jthyn1/underwater_multi-medium_modem_system/README.md

# underwater_multi-medium_modem_system
As part of development of the KnifeBot III underwater ROV in the CA-AI lab, software designated to the seamless operation and access of several underwater modems under the same system, with use-case examples included.
