jthyn1/underwater_multi-medium_modem_system/Documentation/Identify Standards in our project.docx

1) TCP/IP (Internet Protocol Suite – IETF Standard) (Mario Rodriguez)

1. The standard body: Internet Engineering Task Force (IETF)

2. what is the official standard number/identification; if there are multiple related standards, describe the purpose of the multiple standards and list the number for one of the standards

Number: RFC-793, RFC-791
Purpose: Transmission Control/IP is intended for reliable host–to–host connections for multi-network environments. The TCP/IP protocol relies on the internet to handle reassembly and fragmented packets when transmission. The Internet protocol is layered below the TCP protocol.

3) what is the official name of the standard

- Transmission control protocol

2) HTTP (Hypertext Transfer Protocol (Laiba)

1. The standard body: Internet Engineering Task Force (IETF)

2. Official standard number/identification: HTTP uses many related standards called Requests for Comments (RFC) that are published by the Internet Engineering Task Force. These different RFG documents exist because each focuses on a different part of how HTTP works. For example, the structure of messages, or the communication between the client and the server. One of the most current standard is RFC 9110

3. Official name of the standard: RFC 9110 – HTTP Semantics

Source: https://datatracker.ietf.org/doc/html/rfc9110

3). Python programming language (Laiba)

1. The standards body: Python Software Foundation (PSF)

2. official standard number/Identification: Python does not have a official ISO or IEEE standard number like how our other technologies have. Instead, Python uses a Python Enhancement Proposal (PEP) system, which is used for changing documents and making improvements to the language. Each PEP focuses on a different aspects of Python. For example, PEP 8 is the most common standard that gives you a guide on how to write clean and easy code.

3. official name of the standard: PEP 8- Style Guide for Python Code

Source: https://docs.python.org/3/reference/

4.) IEEE 802 Networking Model (Nicholas Alberto)

1. The standard body: Institute of Electrical and Electronics Engineers (IEEE)

2. what is the official standard number/identification; if there are multiple related standards, describe the purpose of the multiple standards and list the number for one of the standards:

This standard defines networking technologies used in local area networks. Its how devices communicate at the physical and data link layers, including how data frames are transmitted between devices on a wired or wireless network. It also includes standards such as ethernet and Wi-Fi.

3. what is the official name of the standard:

IEEE 802 local area network and metropolitan area network standards

5) RS-232 Serial Communication Standard (EIA/TIA-232) (Nicholas Alberto)

1. The standard body:

Electronic industries Alliance and telecommunications industry association

2. what is the official standard number/identification; if there are multiple related standards, describe the purpose of the multiple standards and list the number for one of the standards:

This standard defines serial communication between devices such as computers and hardware peripherals. It described voltage levels, signal timing, and data transmission methods used in serial ports.

3. what is the official name of the standard:

Interface between data terminal equipment and data circuit terminating equipment

6) POSIX (Portable Operating System Interface) (Mario Rodriguez)

1. The standard body: IEEE Computer Society

2) What is the official standard number/identification; if there are multiple related standards, describe the purpose of the multiple standards and list the number for one of the standards.

Number: IEEE Std 1003.1 - 2024
Purpose: Portable Operating System Interface (POSIX) is for portable microcontrollers, either with or without graphical user interfaces (GUI). The interface is specifically designed for several groups of consumers, the commercial users which use the best within their respective computational tasks. The average consumer of hardware and software systems, people who implement their own software/hardware on top of this architecture for the operating system of the portable devices, and lastly those who need it for portable applications. POSIX will utilize several features present in general purpose computers. These include similar naming schemas, similar interface systems ideally with their own customized but same shells/utilities and then rationale. POSIX because its development has been essential to our development of our hardware/software applications.

3) What is the official name of the standard.

- IEEE Standard for Information Technology - Portable Operating System Interface (POSIX)

IP Addressing Standard (IPv4/IPv6 - IETF)

Allows devices on your network (e.g., 192.168.x.x or 10.0.x.x) to uniquely identify and communicate with each other.

7) Raspberry Pi Linux Scheduling (crontab) David Osemene

- Standards Body: The Open Group
- Standard Number: POSIX IEEE 1003.1
- Official Name: Portable Operating System Interface (POSIX) Base Specifications

Explanation:

The cron/crontab command follows the POSIX standard, enabling the scheduling of scripts to run at specified times. This command is used for the Linux operating system. In this project, it is utilized for the automation of scripts at the time of booting the Raspberry Pi.

8) 3D Mechanical Design (SolidWorks CAD) David Osemene

- Standards Body: International Organization for Standardization (ISO)
- Standard Number: ISO 10303 (STEP)
- Official Name: Industrial Automation Systems and Integration — Product Data Representation and Exchange

Explanation:

3D mechanical components such as the enclosure frame that holds all our boards are designed in SolidWorks. The STEP standard allows CAD models to be exchanged between different design and manufacturing software.

Jeremy Thyn:

9) Ethernet

Standard body: IEEE

Standard Number: IEEE 802.3

Official Name: Standard for Ethernet

IEEE Standard 802.3 depicts the technology behind ethernet cables and connections and how they are used. Specifies the MAC (media access control), MIB (managment information base), and many other aspects of the communication protocol. We are currently using it to connect the underwater optical modem to our raspberry pi.

10) LoRa

Standard body: IEEE

Standard Number: IEEE SA - P1451.5.5

Official Name: Standard for a Smart Transducer Interface for Sensors and Actuator -- Wireless Communication Protocols and Transducer Electronic Data Sheet (TEDS) Formats - LoRa Protocol

LoRa (or low power long range) is another form of data communication being used in our project. A LoRa module will be connected to our unit and allow for interfacing with the unit remotely to talk to the raspberry pi without having to have a direct wired interface with it. LoRa specifically is being used as the long range low power nature of it allows for a long distance minimal attenuation, although bps limited communication to receive incoming sensor data and transmission of basic instructions to the unit.

References:

[1] IEEE SA - standard for a smart transducer interface for sensors and actuator -- wireless communication protocols and Transducer Electronic Data Sheet (TEDS) formats - Lora Protocol. IEEE Standards Association. (n.d.). https://standards.ieee.org/ieee/1451.5.5/10611/

[2] IEEE SA - IEEE Standard for ethernet. IEEE Standards Association. (n.d.-a). https://standards.ieee.org/ieee/802.3/10422/

[3]

[4]

[5]

[6]

[7] "IEEE/Open Group Standard for Information Technology--Portable Operating System Interface (POSIX™) Base Specifications, Issue 8," in IEEE/Open Group Std 1003.1-2024 (Revision of IEEE Std 1003.1-2017) , vol., no., pp.1-4107, 14 June 2024, doi: 10.1109/IEEESTD.2024.10555529. keywords: {IEEE Standards;Information technology;Open systems;Operating systems;Application programming interfaces;application program interface (API);argument;asynchronous;basic regular expression (BRE);built-in utility;byte;child;command language interpreter;CPU;extended regular expression (ERE);FIFO;file access control mechanism;IEEE 1003.1™;input/output (I/O);job control;network;parent;portable operating system interface (POSIX™);shell;stream;string;synchronous;system;thread;X/Open System Interface (XSI)},

[8] The Open Group. (2018). The Open Group Base Specifications Issue 7, IEEE Std 1003.1-2017 (POSIX). Retrieved from https://pubs.opengroup.org/onlinepubs/9699919799/

Linux manual page for crontab:
https://man7.org/linux/man-pages/man5/crontab.5.html

[9] International Organization for Standardization. (2021). ISO 10303: Industrial automation systems and integration — Product data representation and exchange. Retrieved from https://www.iso.org/standard/63141.html
