jthyn1/underwater_multi-medium_modem_system/Documentation/Module 8 - Requirements Specifications and System Level Design.docx

Requirements

Specifications for KnifeBot Modem

Laiba Baig

Jermey Thyn

David Osemene

Nicholas Alberto

Mario Rodriguez Avila

Sponsor

Dr. Georgios Sklivanitis

College of Engineering and Computer Science

________________________

The College of Computer Science and Electrical Engineering

777 Glades Road, Boca Raton, FL 33431

Version: 1.0

# Table of Contents

# 1. Introduction

In this document, we will discuss a high-abstraction level of detail for the operation of the Underwater Multimodal Modem for the Knifebot fish robot. We will base this document on the IEEE-830 standard Recommended Practice for Software Requirements Specifications[^1]. Though the project we are creating is not exclusive to software, it still provides a good foundation on which to build our requirements specification. These standards address functionality, interfacing, performance, attributes, and design constraints. It is important to note that this document will not go over design requirements.

### 1.1 Definitions

- Modem – a device that sends and receives data between two signals
- Buoy – A device that helps relay signals between underwater systems and the surface
- Knifebot – An underwater robot that collects data and performs tasks
- Surface Station – The main controls unit that will be user controlled above the surface of the water
- Hydrophone – an underwater microphone that analyzes sound in water by converting it into electrical signals.

# 2. Functionality

The purpose of this project is to create a reliable way for the KnifeBot to communicate underwater by using both acoustic and optical sensors. This helps the robot send data and receive commands from the surface even when the water conditions change and are not ideal. The goal is to improve underwater research and exploration by building a system that can switch between communications to keep the connection strong.

The Underwater Multimodal Modem:

- Enables two-way underwater communication between the KnifeBot and the surface station
- Transmits control commands from the operator to the KnifeBot and send sensor data from the KnifeBot to the surface station in real time
- Allows for multiple underwater modems to communicate within a swarm network without interference
- Monitors the acoustic and optical signals’ strength
- Gives feedback if communication failures happen.

# 3. Interfacing

The modem exists as a transceiver and allows for receiving and sending signals acoustically and/or optically with infrared light. The transceiver will interact with other Knifebots directly or with the surface station. Once a signal is received by the modem, it will be forwarded to the main CPU of the Knifebot, which will determine what the Knifebot will do with the information. The way the modem interfaces is the core of its use, as it is designed as an apparatus for communication of the Knifebot to the rest of the world around it.

# 4. Performance

When reviewing the performance of the modem, we can look individually at the performance of both the optical and acoustic communication subsystems:

## 4.1 Optical Performance

The performance of the modem is dependent on the bandwidth of the signals used with the acoustic and optical portions of the modem. The infrared light portion of the modem uses IR light diodes that, based on the power and arrangement, can transmit up to 4 Mbps. The IrDA (Infrared Data Association) has standard operational parameters for IR communications, which include SIR (Slow IR) at 115 Kbps, MIR (Medium IR) at 1 Mbps, and FIR (Fast IR) at 4 Mbps[^2]. The main drawback of all IR communications is range, as it can only operate at around 3.3 ft, which is further limited by environmental conditions (specifically within the ocean, the clarity of the water is a major issue for any optical communication).

## 4.2 Acoustic Performance

The acoustic part of the modem will be able to operate at a much longer distance regardless of water conditions, however the amount of data able to be transferred will be significantly smaller. There are many different techniques to use acoustics for communication, one of which is FSK (Frequency Shift Keying), which involves having logic 1 and logic 0 assigned to different frequencies that are transmitted/received[^3]. Telemetry using this method can reach up to 5 kbps using multiple FSK channels between 20 kHz and 30 kHz, and at this range we can expect an operating distance anywhere between 10-100 km[^4]. The acoustic modems will use hydrophones to further assist in filtering sound waves. This instrument will be crucial for practical applications and allow better end-to-end communication as a result.

## 4.3 Buoy System

This is a buoy system that functions as a capable monitoring station in the oceans meant to help in data transmission over a long period. It is also fitted with a data logger that consumes a less amount of power as well as a communication device that enables data transmission in real time. It is battery-operated, capable of operating indefinitely in the water as well as in harsh weather. Its transmission range is usually a distance of up to 10km via cellphone/radio communication.

# 5. Attributes

In the IEEE-830 standards, the attributes of a given requirements specifications include reliability, availability, security, maintainability, and portability. For the scope of this document, however, we can omit the availability metric as the only availability necessary is through the CPU.

## 5.1 Reliability

When discussing reliability in the context of the IEEE-830 standards, we are talking about what is required to ensure reliable function of the modem. This includes enough power being driven to the modem to support equal usage of both the optical and acoustic parts, thorough testing of the code that drives the modem to ensure minimal errors and testing in multiple environments to determine potential environmental reliability factors that can be addressed. A performance test will be conducted with parameters that determine if the modem is operational to the desired standard.

## 5.2 Security

While security on the software end is minimal as it is unlikely that the modem will be the subject of a hack, the hardware must be protective enough to stop any external tinkering and any water damage. This means a watertight seal within the Knifebot is essential, so the size of the modem must be considered. Additionally, the materials used to embed the modem should be safe for long use in salt water without rusting, and all connections should lock securely, so they do not come loose during use.

## 5.3 Maintainability

The software that the modem contains is easy to maintain and is done so by design. The Knifebot is based on user use-cases, and therefore the code of what it will do will change often. If the software is not easily updated, then its user-end use will suffer greatly. Additionally, the Knifebot is still well into its development cycle, meaning that the software of the modem is changed often to fit the needs of testing, and maintainability is critical.

## 5.4 Portability

The main case of needing portability within the modem is very similar to the reasons for maintainability: user-use cases. Being able to easily implement the same system that is used for communication between the Knifebots, buoys, and the surface station can be implemented within other systems such as foreign buoys or a manual remote controller, based on the user’s preference.

# 6. Design Constraints

At a high level, these are some of the constraints that are part of development:

- The system provides a simple interface for users to monitor connection status and mode (acoustic/optical)
- The system supports integration with the Knifebot control software
- There are adjustable signal settings like range and frequency
- The system shows a warning if the signal is weak or the connection to the surface station or other Knifebots are lost

# 7. Safety Requirements

- The system should be fully waterproof to prevent any water damage
- The materials used should be safe for long use in salt water without rusting
- Making sure the modem does not overheat when used for a long period of time
- It should use a safe amount of voltage to avoid any electrical shock
- All connections should lock securely so they do not come loose during usage

# 8. State Descriptions and Transitions

The underwater Multimodal Modem for Knifebot system includes both surface and underwater components that work together to keep communication stable. The surface control station sends commands to the surface buoy, which relays those signals underwater to the modem. The modem goes through different states depending on the environment and signal condition, then sends the data collected back up to the surface buoy.

## 8.1: States

- Surface control station: The user controls the system, starts the task, and receives data once everything is completed
- Surface buoy network: the buoy sends commands from the surface station down to the modem and sends data back up from underwater
- Idle State: The modem is turned on and waiting for the start command
- Environmental check state: The modem checks the water conditions, distance, and signals to choose the best communication mode
- Optical mode: It is used when the water is clear, the buoy is close, and the signal is strong for fast data
- Acoustic mode: It is used when the water is cloudy, the buoy is far, or the signal is weak for longer but slower communication
- Error recovery: used when the signal is lost, the system tries to fix the connection or

switch to a better mode

## 8.2: State transitions

- Surface control station to surface buoy: The user sends a start command to begin
- Surface Buoy to Idle state: the buoy sends the commands to turn on and activate the modem
- Idle to Environmental check: The modem starts checking water condition, distance and signals
- Environmental check to optical mode: if the water is clear, the buoy is close, and the signal is strong
- Environmental check to acoustic mode: if the water is cloudy, the buoy is far, and the signal is weak
- Optical/acoustic mode to Error recovery: There is a problem with the connection status
- Error recovery to Environmental check: after fixing the connection, the system checks conditions again
- Environmental check to Idle: when the task is complete and has ended, the model returns to standby mode
- Idle to Surface buoy to surface control station: the modem sends all the data that was collected to the user through the buoy

# 9. System Level Block Diagram

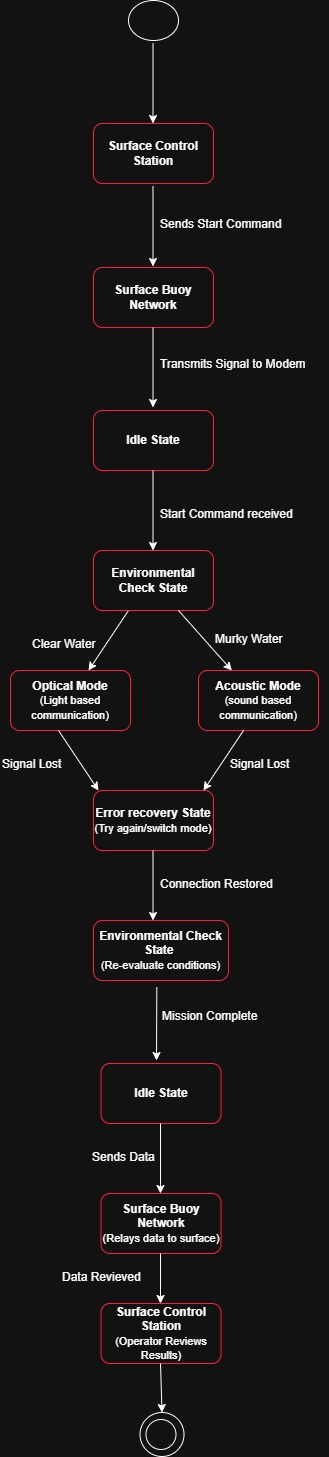
[picture p14: figure]

(Fig 1. System Level Block Diagram for KnifeBot Modem)

## 10.1: Operational Cases

#### 10.1.1: Operation With Clear Water

The user sends a start command from the surface control station through the buoy to the modem. The system moves from idle to environmental check, then switches to optical mode since the water is clear, and the buoy is close. The Knifebot collects the data and sends it back through the buoy. When the task ends, the modem returns idle and sends the data to the surface.

#### 10.1.2: Operation with Murky Water

During the task the modem is working with the optical, but the signal starts to weaken because of cloudy water, or the distance becomes greater than before. The system moves to error recovery state and tries to reconnect. It switches to Acoustic mode through the controller for a more stable connection. After restoring the signal, it returns to environmental check to verify the conditions then continues transmitting data through the buoy until the task is completed.

# 11. References:

"IEEE Recommended Practice for Software Requirements Specifications," in IEEE Std 830-1998 , vol., no., pp.1-40, 20 Oct. 1998, doi: 10.1109/IEEESTD.1998.88286.
keywords: {Software requirements and specifications;contract;customer;prototyping;software requirements specification;supplier;system requirements specifications}

Hydromea SA. “LUMA X and LUMA X-UV Manual.” Feb. 2024, https://files.hydromea.com/luma/LUMA_X_and_LUMA_X-UV_manual.pdf.

Popoto News. “Introducing the PMM4511 – Our New Compact and Efficient OEM Acoustic Modem.” September 30, 2025, Sep. 2025, p. 1, https://www.popotomodem.com/blog/09-30-2025/.

delResearchLLC. “User’sGuidefor PMM5544 M2000/M6000 DB100-55.” Popoto Modem, Jan. 2022, https://www.popotomodem.com/static/17704245ba22b453f7e532e2d40273ee/PMM5544UsersGuide.pdf.

Stojanovic, Milica, and Pierre-Philippe J. Beaujean. Acoustic Communication. https://millitsa.coe.neu.edu/publications/book/handbook-chap5.pdf.

Lish, Tom. “What Is a Data Buoy?” Setra Systems Blog, 25 Jan. 2018,

https://www.setra.com/blog/what-is-a-data-buoy

Campagnaro, F., Steinmetz, F., Renner, B.-C., & Zorzi, M. (2023). Affordable underwater acoustic modems and their application in everyday life: a complete overview. In Proceedings of the 17th International Conference on Underwater Networks & Systems (WUWNet ’23), November 24-26, 2023, Shenzhen, China. ACM. https://doi.org/10.1145/3631726.3631734

[^1] IEEE SA - IEEE Recommended Practice for Software Requirements Specifications. IEEE Standards Association. (n.d.). https://standards.ieee.org/ieee/830/1222/
[^2] Frenzel, L. E. (2005, August 17). IR transceivers boost speed and range. Electronic Design. https://www.electronicdesign.com/technologies/communications/article/21765365/ir-transceivers-boost-speed-and-range
[^3] Froehlich, A. (2021, October 1). What is frequency-shift keying (FSK)?. Search Networking. https://www.techtarget.com/searchnetworking/definition/frequency-shift-keying
[^4] Stojanovic, M. (n.d.). MIT. http://web.mit.edu/millitsa/www/resources/pdfs/ency.pdf
