jthyn1/underwater_multi-medium_modem_system/Documentation/SPRING 2026 SENIOR SHOWCASE POSTER TEMPLATE.pdf

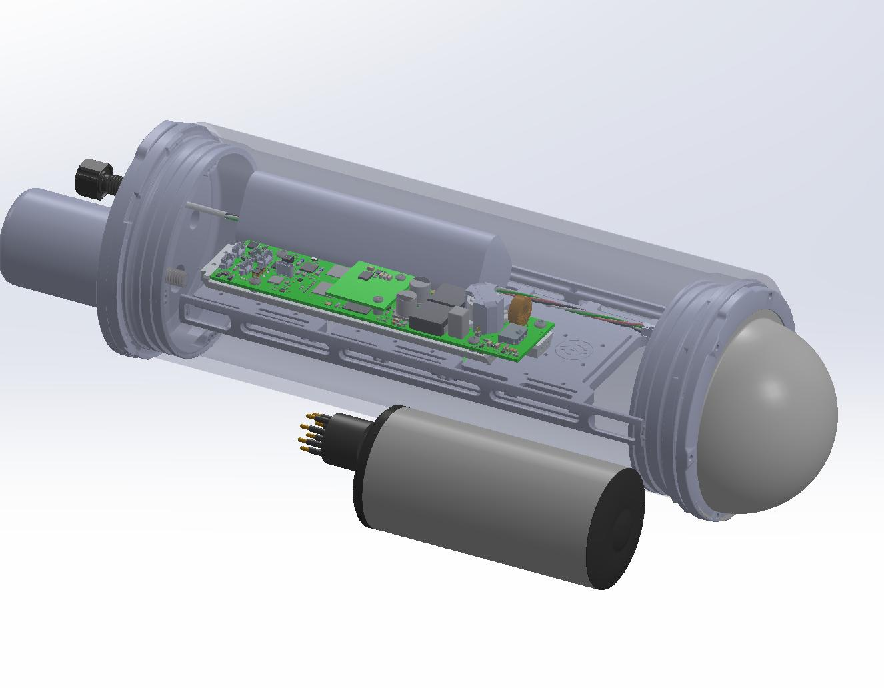
[picture p15: figure]
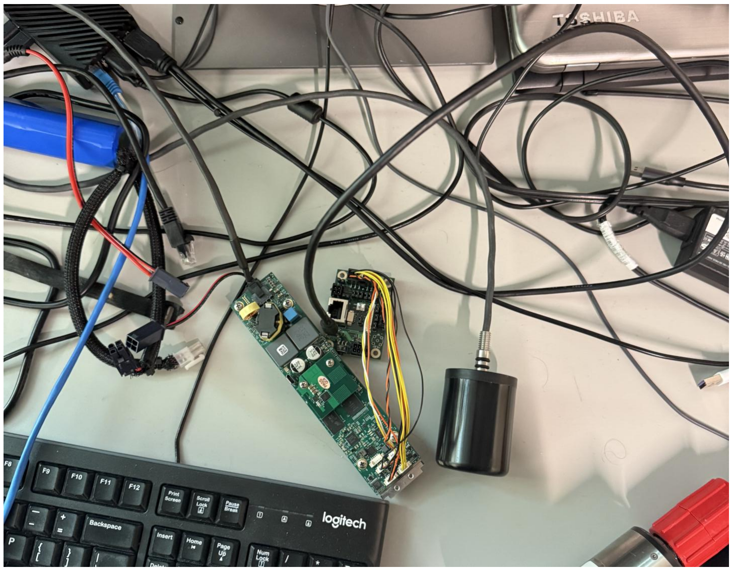
[picture p16: figure]
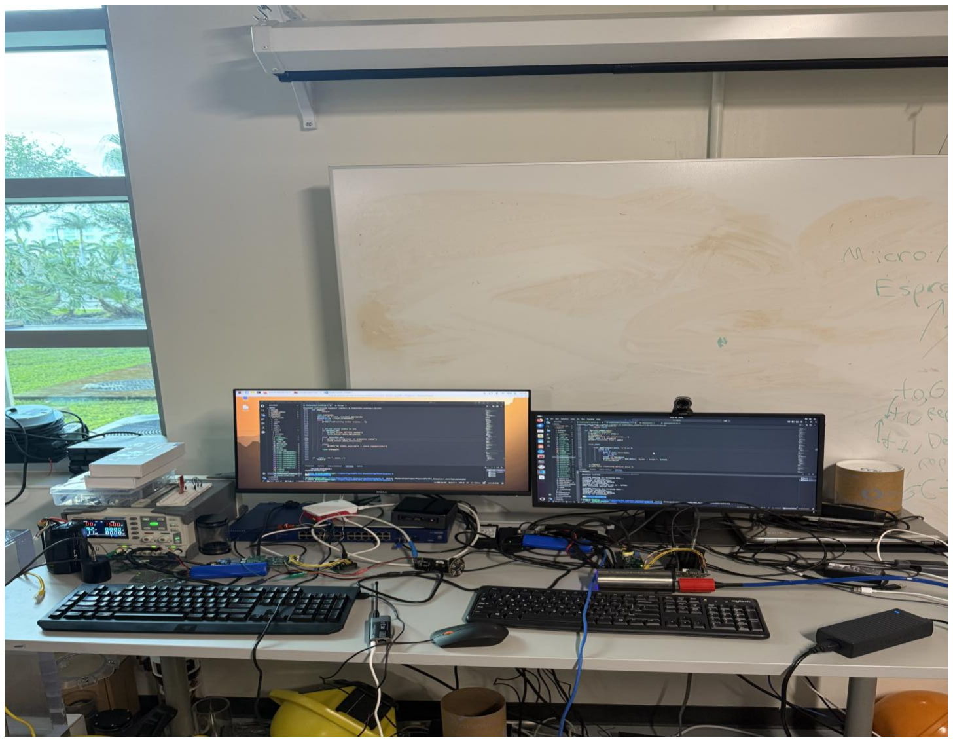
[picture p17: figure]
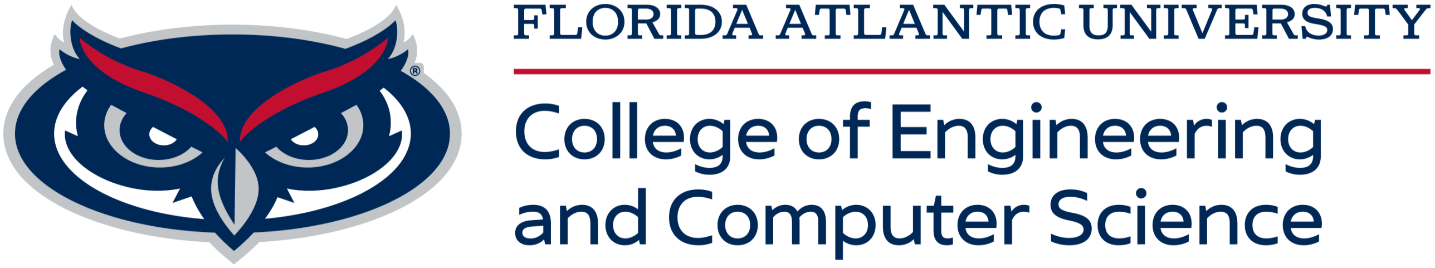
[picture p18: figure]

S E N I O R D E S I G N S H O W C A S E | F A L L 2 0 2 5

EGN 4952C
Electrical Engineering & Computer Science

## Underwater Multimodal Modem for KnifeBot

### Team Members

Jeremy Thyn
David Osemene
Nicholas Alberto | Project Advisor
| Dr. Waseem Asghar


## Problem Statement

Ocean researchers, offshore industry, and government naval operations all require communication networks that can send data across the ocean under the water. However, this can be a challenge especially with higher bandwidth communications as simple radio frequency modems. Our communication network takes advantage of underwater acoustic (UW-A) and underwater optical (UW-O) modems to effectively output the most bandwidth depending on conditions.

Sponsored by: Dr. Georgios Sklivanitis
Center for Connected Autonomy and Artificial Intelligence

## Results

- Dynamic mode initially on the optical modem every 5 seconds (within range 50m). If out of range takes 1 second to readjust to acoustic modem to send data.
- Reliable signal quality using optical modem (low visibility, high UV light interference). Average throughput under test conditions measure 5.32 Kbits/sec. Although supporting theoretical rate (1 Mbps), environmental factors such as noise, alignment and packet overhead can reduce throughput.

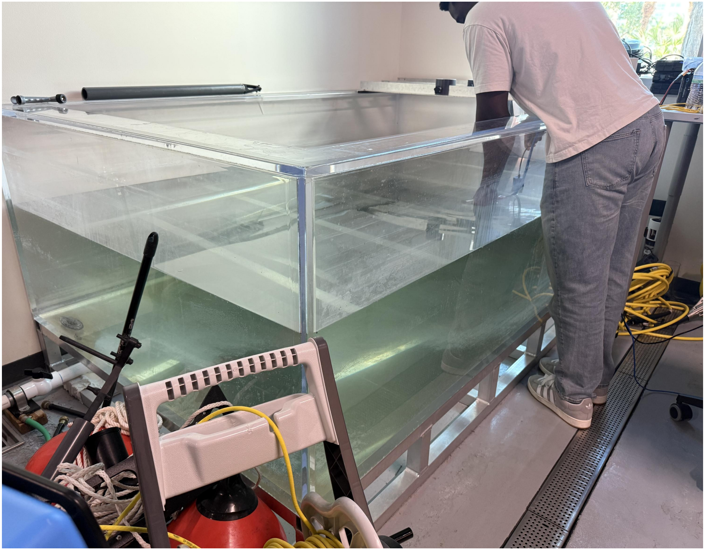
[picture p19: figure]
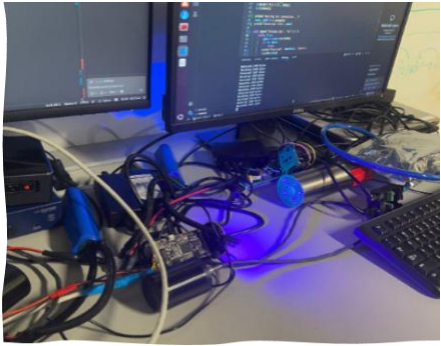
[picture p20: figure]

We faced many challenges, such as the UW-A modem’s reliance on a TCP/IP socket whereas the UW-O relied on network made creating a program that can access both difficult. Resolving these differences, along with the testing of the modems in different conditions and creating the electrical and mechanical components were the bulk of the work. However, we were able to create a system that achieved our goal of an efficient communications unit that works under water.

This system can be applied to ocean reef research (this project is designed specifically for integration with another project, the KnifeBot). Otherwise, this technology can be used with military autonomous drones, live monitoring of underwater cables, or even deep-sea research missions with autonomous drones.

## Conclusions & Impact

#12

### Faculty Course Facilitator

Dr. KwangSoo Yang
Dr. Zhen Ni

Mario Rodriguez

Laiba Baig

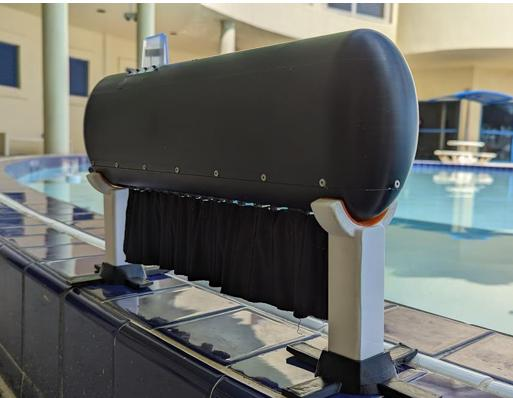
[picture p21: figure]
