jthyn1/underwater_multi-medium_modem_system/Hardware/ED Package (Electrical)/Misc Hardware/Datasheets/CommModules.xlsx

 | Overview | Part Website | Model | P/N | Footprint | Voltage | Rx Amps | Tx Amps | Rx Power Use | Tx Power Use | Frequency Band | BW | Bitrate | Range | Sensitivity | Connection | Unit Cost | Notes: | Advantages: | Disadvantages:
Xbee (ZigBee) | https://en.wikipedia.org/wiki/Zigbee | https://www.digi.com/products/models/xb3-24acm-j | Micro Xbee pro 3 802.15.4 | XB3-24ACM | 19 mm x 13 mm | 2.1V – 3.6V | 17 mA | 135 mA | 56mW @ 3.3V | 0.45 W @ 3.3V (19 dBm) | 2.4 GHz | 5 MHz | 250 Kbps thru RF | 90 m indoors, 3.2km outdoors | -103 dBm | UART, SPI, I2C | $19.00 |  | Small footprint and low power consumption with high frequency | Lower range and possible WiFi/BLE interference
LoRa | https://en.wikipedia.org/wiki/LoRa | https://heltec.org/project/wifi-lora-32-v4/ | Heltec Automation LoRa V4 | HTIT-WB32LAF | 52 mm x 25.4 mm | 3.3V thru 3v3 pin or batt, 5V thru USB-C, 5V pin, or solar | 75 mA | 300-750 mA | 375mW @ 5V | 1.5W-3.75W (21 – 28 dBm) | 430~510 MHz LF, 863 ~ 928 MHz HF | 7.8-500kHz | 0.3-50 Kbps | 10 km | -135 dBm | ADC1, ADC2, Touch, UART, I2C, I2S, SPI, | $19.00 | ESP32 Based, includes Wifi 802.11 b/g/n and BLE in addition to LoRa | Highly configurable with robust documentation and flexibility. High range and sensitivity based on spread factor/BW | High power consumption, very low bitrate, high latency
HaLow | https://en.wikipedia.org/wiki/IEEE_802.11ah | https://heltec.org/project/ht-hd01/ | Heltec Wi-Fi HaLow Dongle V2 | HT-HD01 | 87.5 mm x 32.5 mm | USB-C, 5V | Unknown | 300mA | Unknown | 1.5 W (21 dBm) | 902 – 928 MHz | 1/2/4/8 MHz | Max 32.5 Mbps @ 8MHz | 1 km | -105/-103/-101/-97 | USB-C, ETH | $69-$138 | Unit is within a dongle, to save space we can remove the circuit from the case within the KnifeBot | Highest bitrate, good range, IP-native | High cost, possibly highest footprint, less robust documentation
Datasheets:
Heltec LoRa Module
https://resource.heltec.cn/download/WiFi_LoRa_32_V4/datasheet/WiFi_LoRa_32_V4.2.0.pdf
Heltec HaLow Dongle
https://resource.heltec.cn/download/HT-HD01/HT-HD01_Rev.1.0.0.pdf
Xbee Micro:
https://mm.digikey.com/Volume0/opasdata/d220001/medias/docus/7905/XB3-24ACM.pdf
