jthyn1/underwater_multi-medium_modem_system/Documentation/Power_Componet_Spreadsheet.xlsx

Sheet: Sensors to Buy
Component | P/N | quantity | price | Total | store link | Owned/Unowned/Unsure | Additional notes | Datasheets/manual:
DO meter | ENV-20-DOX | 1 | $232 | $232 | https://www.digikey.com/en/products/detail/atlas-scientific/ENV-20-DOX/16003119 | owned |  | https://kn.ariat-tech.com/datasheet/8a/ENV-20-DOX.pdf
UW pressure meter | Blue Robotics Bar High-Resolution Depth/Pressure Sensor (BAR30) | 1 | $90 | $90 | https://bluerobotics.com/store/sensors-cameras/sensors/bar-depth-pressure-sensor/ | owned | Needs to be Bar30 version | https://cdn.robotshop.com/media/b/blu/rb-blu-237/pdf/bar30-high-resolution-300m-depth-pressure-sensor-r2-datasheet.pdf
leak sensor | 1597-1127-ND | 3 | $3 | $9 | https://www.digikey.com/en/products/detail/seeed-technology-co-ltd/101020018/5482605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 | Owned |  | https://mm.digikey.com/Volume0/opasdata/d220001/medias/docus/872/101020018_Web.pdf https://bluerobotics.com/store/sensors-cameras/sensors/bar-depth-pressure-sensor/
camera | SC0872 | 2 | $27 | $54 | https://www.newark.com/raspberry-pi/sc0872/rpi-camera-mod-3-standard-lens/dp/62AK8682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 | owned |  | https://www.raspberrypi.com/documentation/accessories/camera.html
Conductivity meter | ENV-20-EC-K1.0 | 1 | $134 | $134 | https://www.digikey.com/en/products/detail/atlas-scientific/ENV-20-EC-K1-0/16003011 | owned |  | https://files.atlas-scientific.com/EC_K_1.0_probe.pdf
GPS | ULTIMATE GPS FEATHERWING MTK3339 | 2 | $30 | $60 | https://www.digikey.com/en/products/detail/adafruit-industries-llc/3133/6047744 | owned |  | https://cdn-learn.adafruit.com/downloads/pdf/adafruit-ultimate-gps-featherwing.pdf
WiFi HaLow Eval kit | MM8108-EKH19-01 | 2 | $200 | $400 | https://www.mouser.com/ProductDetail/Morse-Micro/MM8108-EKH19-01?qs=HMhDvBYWqvOSMbg%2FkiOXMw%3D%3D | owned | Own 1, but need 2 new for implementation | https://www.morsemicro.com/resources/product_brief/MM8108-EKH19-Product-Brief.pdf
IMU | Fermion: 10 DOF IMU Sensor - ADXL345+ITG3205+VCM5883L+BMP280 | 1 | $13 | $13 | https://www.dfrobot.com/product-818.html?gad_source=4&gad_campaignid=23441887437 | unowned | Not Needed (for now) | Datasheet links on store page as downloadable pdf
Temperature meter | SNS-TMP-DS18B20-MAXIM | 1 | $5 | $5 | https://www.dfrobot.com/product-689.html?gad_source=1&gad_campaignid=23441887437 | Unowned | Replaced w/pressure meter | https://www.analog.com/media/en/technical-documentation/data-sheets/ds18b20.pdf
Raspberry Pi 5 Compute Module | SC1571 | 2 | $140 | $280 | https://www.digikey.com/en/products/detail/raspberry-pi/SC1571/25805583 | owned |  | https://pip-assets.raspberrypi.com/categories/944-raspberry-pi-compute-module-5/documents/RP-008180-DS-6-cm5-datasheet.pdf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
RPi 5 Carrier Board | SC1967 | 2 | $20 | $40 | https://www.digikey.com/en/products/detail/raspberry-pi/SC1967/25862723 | owned |  | https://pip-assets.raspberrypi.com/categories/1097-raspberry-pi-compute-module-5-io-board/documents/RP-008182-DS-2-cm5io-datasheet.pdf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
PJRC Teensy 4.1 Development Board | Product ID: 4622 | 2 | $30 | $60 | https://www.adafruit.com/product/4622 | Need one more |  | https://www.pjrc.com/store/teensy41.html
OEM Simple Development Board | #OEM-SDB | 2 | $20 | $40 | https://atlas-scientific.com/carrier-boards/oem-simple-development-board/ | Need one more | DO meter breakout board | https://files.atlas-scientific.com/oem-dev-board.pdf
EZO™ Conductivity Circuit | #EZO-EC | 1 | $68 | $68 | https://atlas-scientific.com/embedded-solutions/ezo-conductivity-circuit/ | owned | Conductivity meter breakout board | https://download.mikroe.com/documents/datasheets/EZO-EC_datasheet.pdf
EZO™ Dissolved Oxygen Circuit | #EZO-DO | 1 | $53 | $53 | https://atlas-scientific.com/embedded-solutions/ezo-dissolved-oxygen-circuit/ | Unowned |  | https://files.atlas-scientific.com/DO_EZO_Datasheet.pdf
Pi power supplies | Geekworm PD 27W 5.1V 5A USB-C Power Supply for Raspberry Pi 5 | 2 | $11 | $22 | https://www.amazon.com/Geekworm-USB-C-Power-Supply-Raspberry/dp/B0FGN6Q8BC | Unowned
CM5 Heat Dissipators |  | 2 | $7 | $14 | https://www.pishop.ca/product/raspberry-pi-compute-module-5-passive-cooler/ | Unowned
Container components | Electronics | Add'l |  | $1538
Watertight Enclosure Seals (8IN) | SKU: BR-100837 | 2 | $20 | $40 | https://bluerobotics.com/store/watertight-enclosures/non-locking-series/wte8-o-ring-set-r1/ | Unowned
Watertight Enclosure Seals (4IN) | SKU: BR-100176 | 2 | $3 | $6 | https://bluerobotics.com/store/watertight-enclosures/locking-series/spare-o-ring-set/ | Unowned
acrylic end-cap(8IN enclosures) lid link | SKU: BR-102206-007 | 1 | $62 | $62 | End Caps and Flange Caps for Subsea Watertight Enclosures (https://bluerobotics.com/store/watertight-enclosures/locking-series/wte-end-cap-vp/) | Unowned
Watertight Enclosure lid(4IN) 5xm10 Hole | SKU: BR-102933-005 | 1 | $36 |  | https://bluerobotics.com/store/watertight-enclosures/locking-series/wte-end-cap-vp/ | Unowned | Needs to be 100mm(4IN) and Aluminum 5x10 hole (1000m)
Watertight Enclosure tube (4IN) | SKU: BR-100665 | 1 | $50 | $50 | O-ring Flange for Custom Underwater Housings (https://bluerobotics.com/store/watertight-enclosures/locking-series/wte-flange-vp/) | Unowned
Watertight Penetrators | SKU: BR-101086 | 10 | $6 | $60 | Potted Cable Penetrator for Subsea Electrical Cables (https://bluerobotics.com/store/cables-connectors/penetrators/penetrator-vp/) | Unowned | Need to be 6mm
Enclosure Vent Valve (8IN Enclosure) | SKU: BR-100783 | 1 | $12 | $12 | https://bluerobotics.com/store/watertight-enclosures/enclosure-tools-supplies/vent-asm-r1/ | Unowned
Enclosure Vent Valve (4IN Enclosure): | SKU: BR-100804 | 1 | $32 | $32 | Pressure Relief Valve (PRV) (https://bluerobotics.com/store/watertight-enclosures/enclosure-tools-supplies/prv-m10-asm/) | Unowned
Enclosure Seal lubricant | SKU: BR-100558 | 1 | $30 | $30 | https://bluerobotics.com/store/watertight-enclosures/enclosure-tools-supplies/molykote/ | Unowned
Enclosure vacuum plug | SKU: BR- 101118 | 1 | $8 | $8 | https://bluerobotics.com/store/watertight-enclosures/enclosure-tools-supplies/vacuum-plug/?add-to-cart=136035 | Unowned
Enclosure pressure gun | SKU: BR - 100297 | 1 | $98 | $98 | https://bluerobotics.com/store/watertight-enclosures/enclosure-tools-supplies/vacuum-pump-kit-r2-rp/ | Unowned

Sheet: To order
Item | P/N | Quanity | Unit Price (Rounded) | Total | Store Link
Pi power supplies | Geekworm PD 27W 5.1V 5A USB-C Power Supply for Raspberry Pi 5 | 2 | $15 | $30 | https://www.amazon.com/Geekworm-USB-C-Power-Supply-Raspberry/dp/B0FGN6Q8BC
CM5 Heat Dissipators |  | 2 | $7 | $14 | https://www.pishop.ca/product/raspberry-pi-compute-module-5-passive-cooler/
EZO™ Dissolved Oxygen Circuit | #EZO-DO | 1 | $53 | $53 | https://atlas-scientific.com/embedded-solutions/ezo-dissolved-oxygen-circuit/
OEM Simple Development Board | #OEM-SDB | 1 | $20 | $20 | https://atlas-scientific.com/carrier-boards/oem-simple-development-board/
 |  |  | Total: | $117

Sheet: Components
Component | Name | Amount | Unit Cost:
Raspberry Pi 5 8 GB | x | 2x | $125.00
Popoto PMM4511 Breakout Board | x | 2x | x
Popoto PMM4511 UW-A | x | 2x | x
Luma-X UV Bare UW-O Unit | x | 1x | x
Luma-X UV cased UW-O Unit | x | 1x | x
Luma-X UV Breakout Connector | x | 1x | x
25 ft HDMI Cord | Amazon Basics HDMI Cable, 25ft, 4K@60Hz | 1x | $14.00
HDMI-MicroHDMI Adapter | Raspberry Pi SC0726 | 1x | $4.00
Ethernet Cables | Cable Matters 10Gbps 5-Pack Snagless Short Cat 6 Ethernet Cable - 1ft | 4x | $12.50
18 AWG power wires | 18 Gauge Wire, 18 AWG 2 Conductor Electrical Wire |  | $14.00
BlueRobotics-LI-4S-15.6Ah | x | 2x | x
Camera option #1 | pi module 3 | 1x | $37.00
Camera option #2 | Arducam Pi Camera |  | $25.00
Camera option #3 | innomaker |  | $18.00
DS18B20 Temperature Sensor | BOJACK | 1x | $9.00
Conductivity sensor | Garosa Water Conductivity Sensor | 1x | $11.00
Dissolved oxygen Sensor | Gravity Analog Dissolved Oxygen Meter | 1x | $24.00
Embedded PCB Components: |  | Per PCB:
XT30PW (J6) | x | 1x
4A Fuse (F1) | Bel Fuse Inc. 0697H4000-01 | 1x | $0.50
YO0401500000G (J3) | Amphenol Anytek YO0401500000G | 1x | $1.20
MC14043B (U3A) | ONSEMI CMOS MSI Quad R-S Latches | 1x | $0.50
59155 (SW1) | 59155 Subminiature Flange Mount Reed Sensor | 1x | $3.00
TPS565208 (U1) | TI TPS565208 4.5-V to 17-V Input, 5-A Synchronous Step-Down Voltage Regulator in SOT-23 | 1x | $1.38
1N4148WT (D1) | ONSEMI 1N4148WT diode | 1x | x
SMF36A (D2) | Littelfuse TVS SMF 36V Uni, 7'' T&R | Series: SMF | 1x | $0.20
LED (D3) | Generic (Green) | 1x | x
LED (D4) | Generic (Blue) | 1x | x
FQD11P06TM (Q1) | MOSFETs TO-252 DPAK P-CH 60V | 1x | x
BSS138LT1 (Q2) | MOSFETs 50V 200mA N-Channel | 1x | x
55k Resistor (R1) | Generic | 1x | x
10k Resistor (R2, R5, R6, R9) | Generic | 4x | x
6.8k Resistor (R10) | Generic | 1x | x
680 Resistor (R3, R8) | Generic | 2x | x
330 Resistor (R4, R7) | Generic | 2x | x
10uF +/- Capacitor (C1, C6) | Generic | 2x | x
22uF +/- Capacitor (C2) | Generic | 1x | x
100nF Capacitor (C3, C4) | Generic | 2x | x
3.3uH Inductor (L1) | Generic | 1x | x

Sheet: Power
Component | Usage | Voltage (V) | Passive power consumption (Receiving/Idling) (W) | Current Draw (mA) | Active power consumption (Transmitting/Computing) (W) | Current Draw (mA) | Active Duty Cycle % | Average Power Consumption (W) | Contingency % | Total Power Consumption (W): | Additional Notes
Luma-X UV | KnifeBot/Demo | 12-36V, using 24V | 2 | 83.33 | 2-17 (9.5 Avg) | 83.33-708 (395 Avg) | ~60% for transmitting video streaming data | 6.5 | 15.00% | 7.48 | Based on calculations from provided manual/datasheet (See sources)
Popoto PMM4511 | KnifeBot/Demo | 14-40V, using 24V | 1.2 | 83.33 | 3.1-10 (6.55 Avg) (based on sound dB from transducer) | 129-416 (273 Avg) | ~10% for sensor data transmission/Up to 70% if UW-O cannot effectively transmit | 1.47/4.95 | 10.00% | 1.6/5.45 | Based on calculations from provided manual/datasheet (See sources)
Raspberry Pi5 | KnifeBot/Demo | 5V | 2.7 | 540 | ~4.5 (based on CPU load of processing heavy data) | 900 | ~20% for processing heavy amounts of data | 3 | 20.00% | 3.67 | Requires 5V/5A USB-C supply. Some information gathered from unofficial sources due to no official information provided (See sources)
Raspberry Pi camera module 3 | Demo | 5V | Nominal | Nominal | 1.25 while streaming | 250 | ~95% for a constant video stream | 1.19 | 5.00% | 1.25 | Some information gathered from unofficial sources due to no official information provided (See sources)
Waterproof DS18B20 Digital Temperature Sensor | Demo | 5V | Nominal | x | Nominal | x | x | x | x | Nominal
Total Average power consumption per unit (Typical UW-O & UW-A operation): 14W
BlueRobotics LI-4S Battery: 266Wh
Total operation time before drainage: 19 hours
Sources:
Popoto PMM4511:
https://www.popotomodem.com/static/ca0f73484914bd9f3810e274074fa2e9/PMM4511-Technical-Specifications.pdf
https://www.popotomodem.com/documentation/
Luma-X:
https://files.hydromea.com/luma/LUMA_X-UV.pdf
https://files.hydromea.com/luma/LUMA_X_and_LUMA_X-UV_manual.pdf
Raspberry Pi 5:
https://pip-assets.raspberrypi.com/categories/892-raspberry-pi-5/documents/RP-008348-DS-5-raspberry-pi-5-product-brief.pdf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
https://www.jeffgeerling.com/blog/2024/new-2gb-pi-5-has-33-smaller-die-30-idle-power-savings/
https://www.origin-ic.com/blog/raspberry-pi-5-8gb/47752#heading-4
Raspberry Pi camera module 3:
https://www.reddit.com/r/raspberry_pi/comments/1mc4x4g/anyone_know_the_power_consumption_of_the_pi/
https://www.raspberrypi.com/documentation/accessories/camera.html
DS18B20 Digital Temperature Sensor:
https://mm.digikey.com/Volume0/opasdata/d220001/medias/docus/3786/DFR0198_Web.pdf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
