jthyn1/underwater_multi-medium_modem_system/Hardware/3D Design files/BASE_PLATE.STL

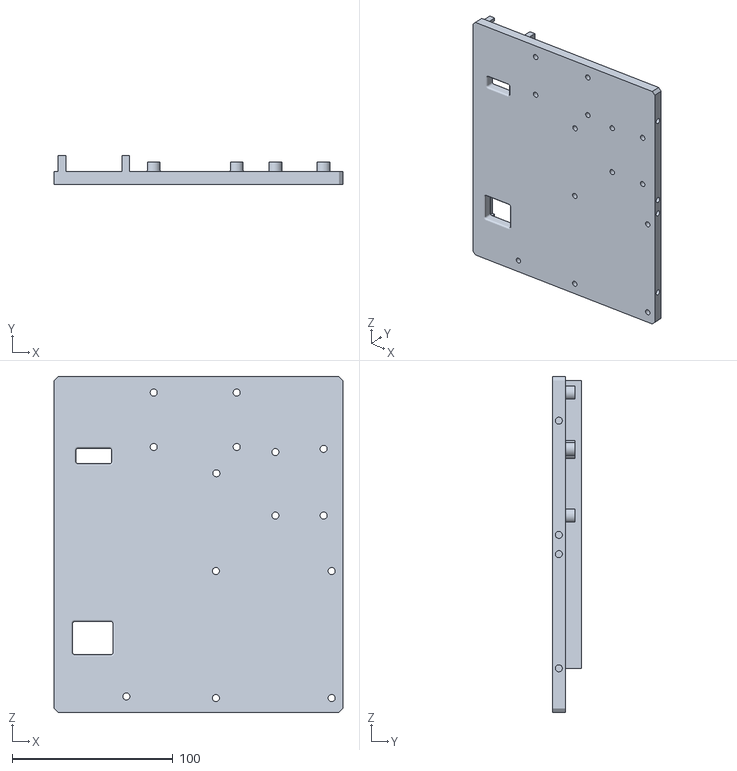
[picture p22: CAD file, 2026-07-20]
Hardware/3D Design files/BASE_PLATE.STL
179.7 x 18.1 x 209.0
