jthyn1/underwater_multi-medium_modem_system/Hardware/3D Design files/ROTATE_PLATE.STL

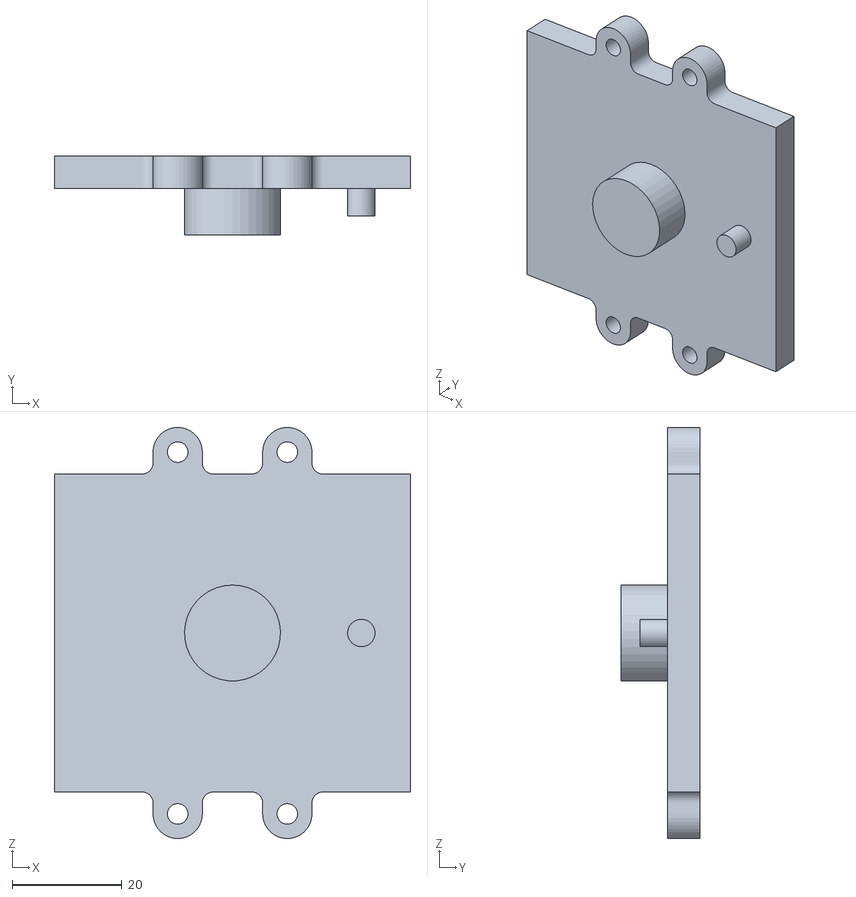
[picture p23: CAD file, 2026-07-20]
Hardware/3D Design files/ROTATE_PLATE.STL
65.0 x 14.5 x 75.0
