jthyn1/underwater_multi-medium_modem_system/Hardware/3D Design files/OP_SENSOR_BOTTOM.STL

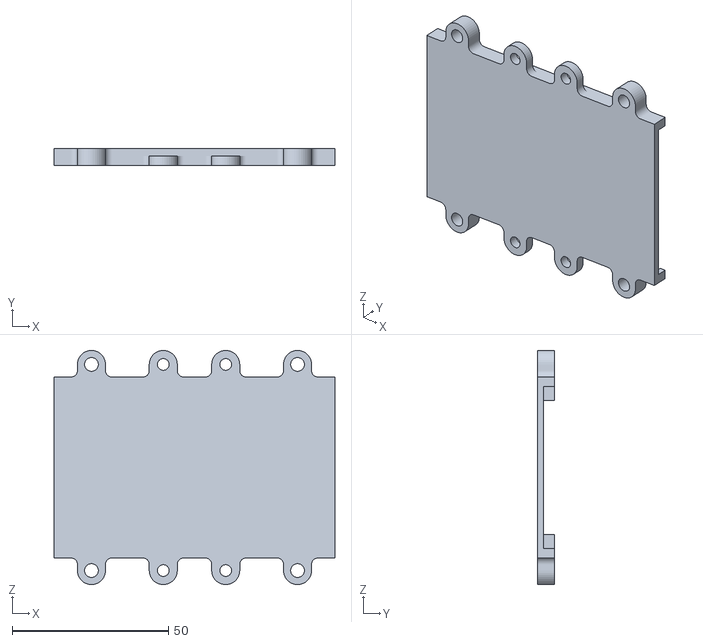
[picture p24: CAD file, 2026-07-20]
Hardware/3D Design files/OP_SENSOR_BOTTOM.STL
90.0 x 5.50 x 75.0
