jthyn1/underwater_multi-medium_modem_system/Hardware/3D Design files/OP_SENSOR_TOP.STL

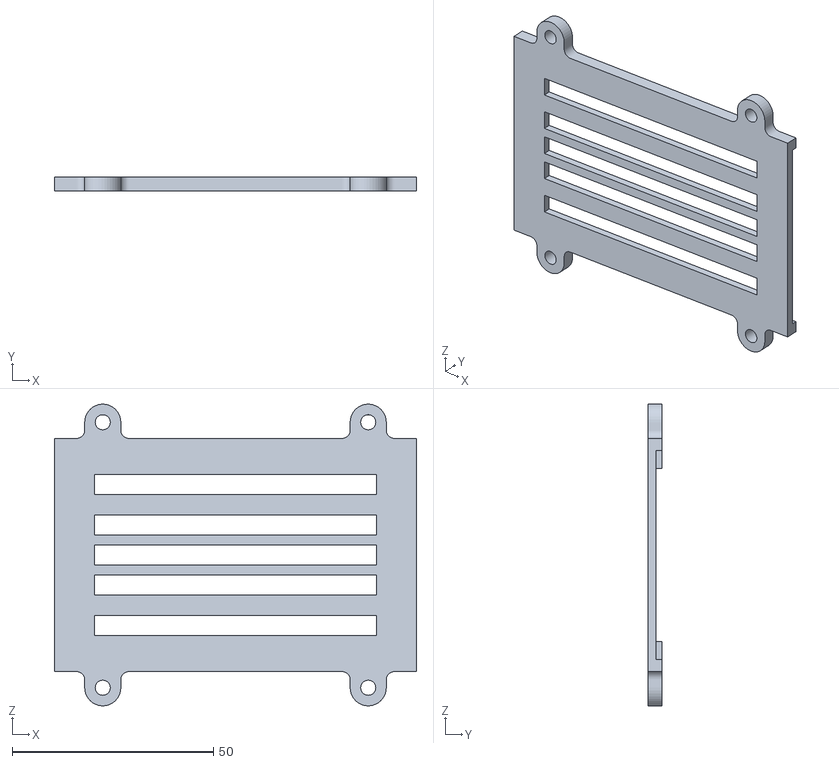
[picture p25: CAD file, 2026-07-20]
Hardware/3D Design files/OP_SENSOR_TOP.STL
90.0 x 3.50 x 75.0
