jthyn1/underwater_multi-medium_modem_system/Hardware/3D Design files/WP_OP_SENSE_TABLE.STL

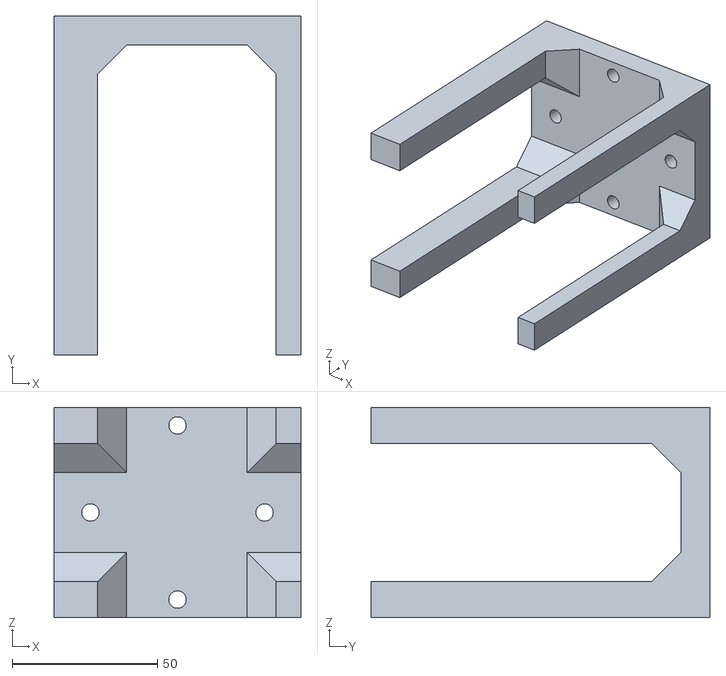
[picture p26: CAD file, 2026-07-20]
Hardware/3D Design files/WP_OP_SENSE_TABLE.STL
85.0 x 116.8 x 72.5
