jthyn1/underwater_multi-medium_modem_system/Hardware/3D Design files/OP_SENSE_TABLE.STL

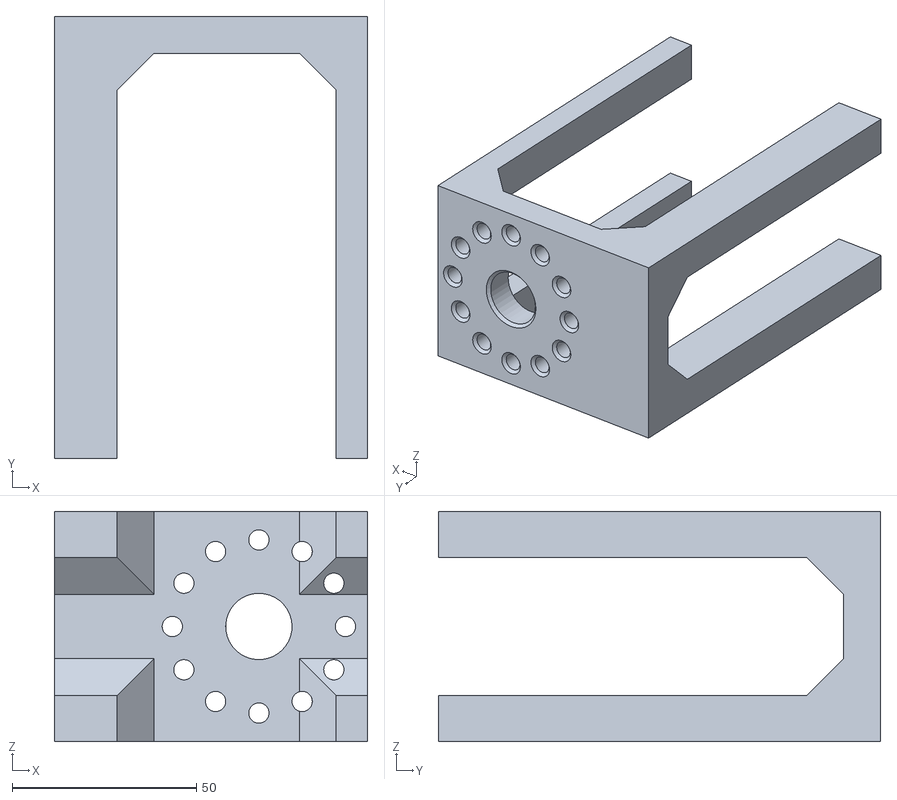
[picture p27: CAD file, 2026-07-20]
Hardware/3D Design files/OP_SENSE_TABLE.STL
85.0 x 120.0 x 62.5
