jthyn1/underwater_multi-medium_modem_system/Hardware/3D Design files/OP_SENSOR_TOP_V2.STL

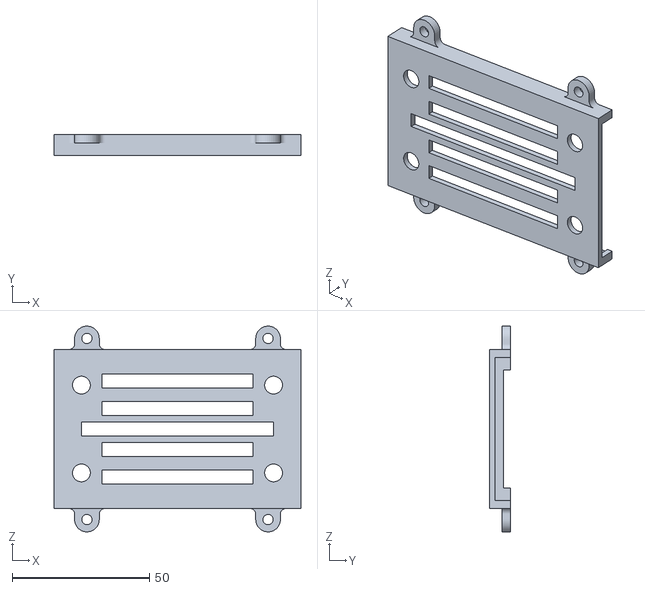
[picture p28: CAD file, 2026-07-20]
Hardware/3D Design files/OP_SENSOR_TOP_V2.STL
90.0 x 7.54 x 75.0
