jthyn1/underwater_multi-medium_modem_system/Hardware/ED Package (Electrical)/Misc Hardware/Wiring Diagrams/ModemUnit#1.pdf

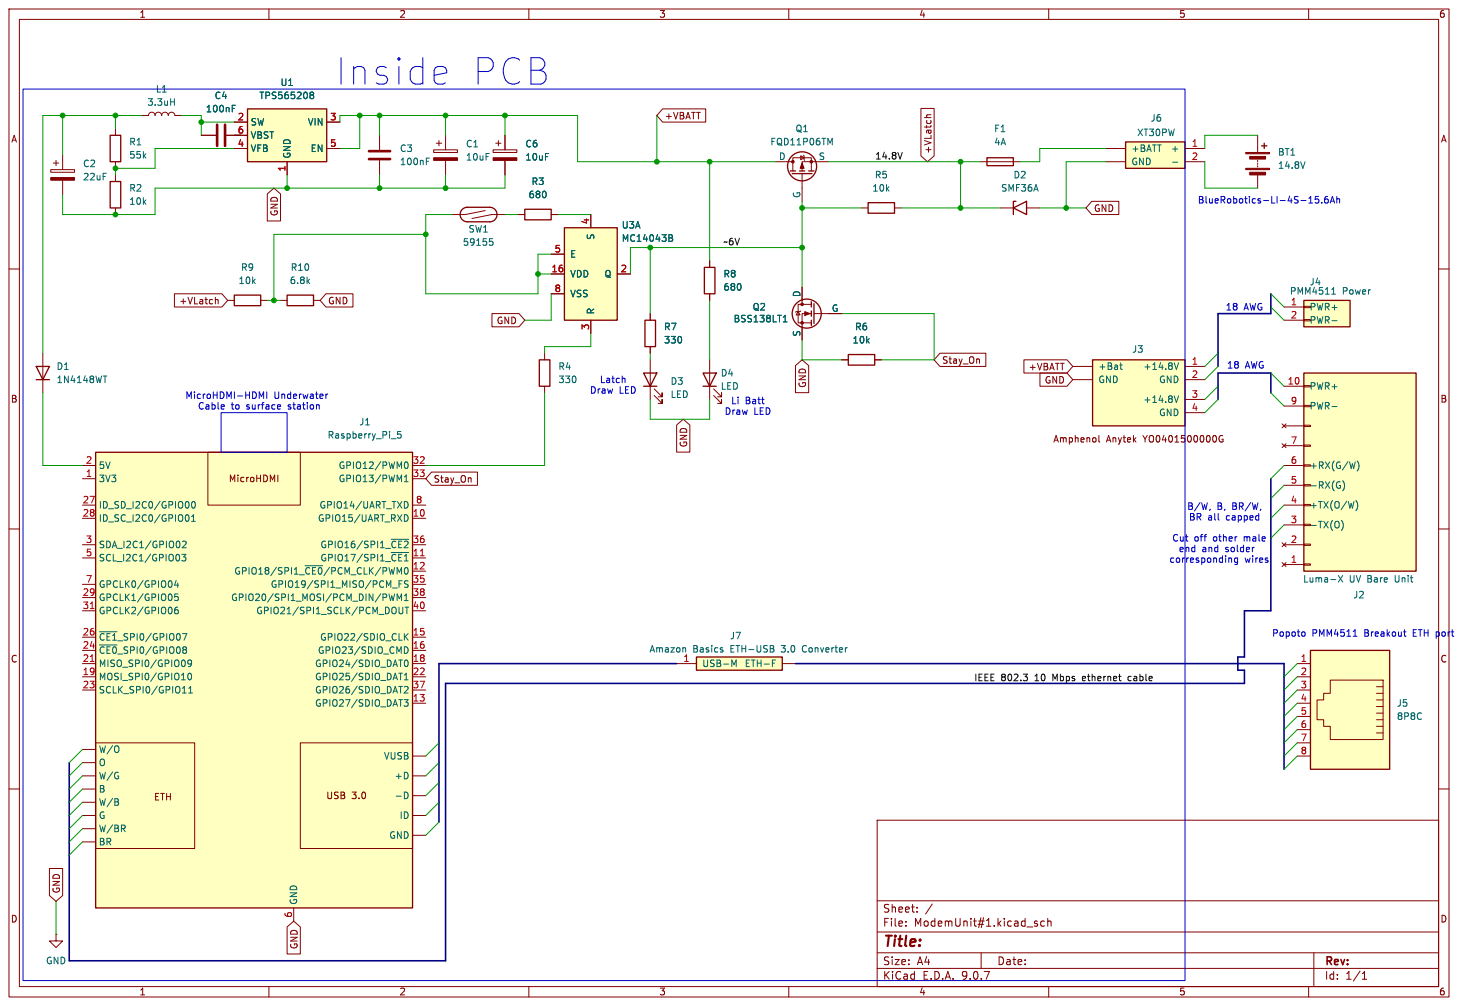
[picture p29: page 1]

Popoto PMM4511 Breakout ETH port B/W, B, BR/W, BR all capped

Cut off other male

Id: 1/1 Title: File: ModemUnit#1.kicad_sch Sheet: /
