jthyn1/underwater_multi-medium_modem_system/Hardware/ED Package (Electrical)/Misc Hardware/Wiring Diagrams/ModemUnit#2.pdf

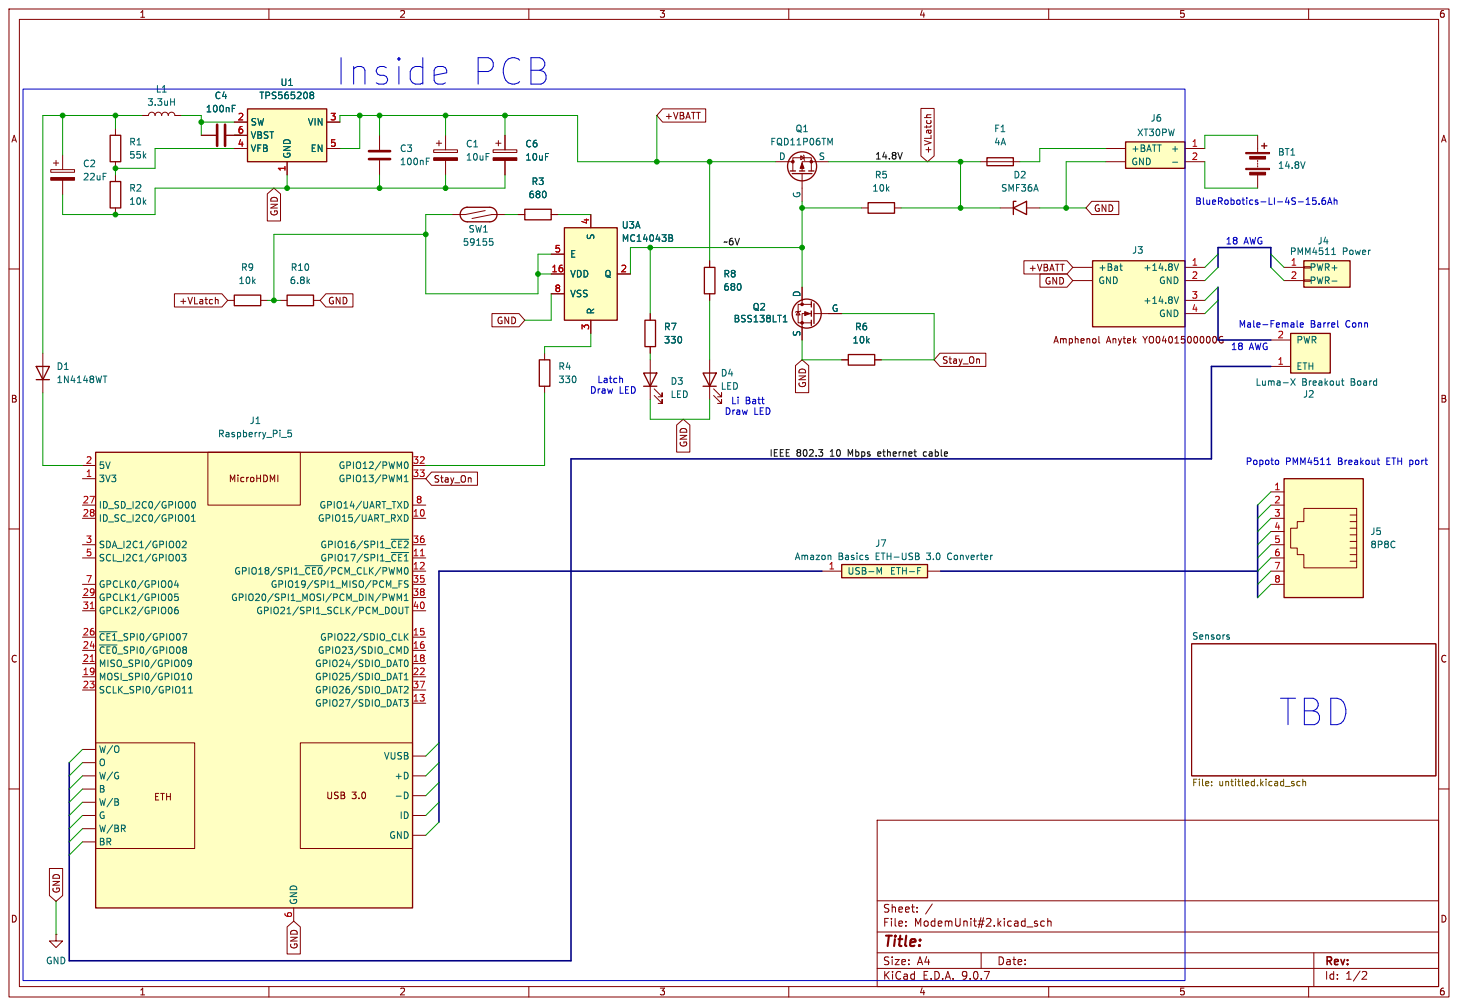
[picture p30: page 1]

Popoto PMM4511 Breakout ETH port Inside PCB

J4 PMM4511 Power VIN 3 EN 5 GND

J7 Amazon Basics ETH-USB 3.0 Converter SW1

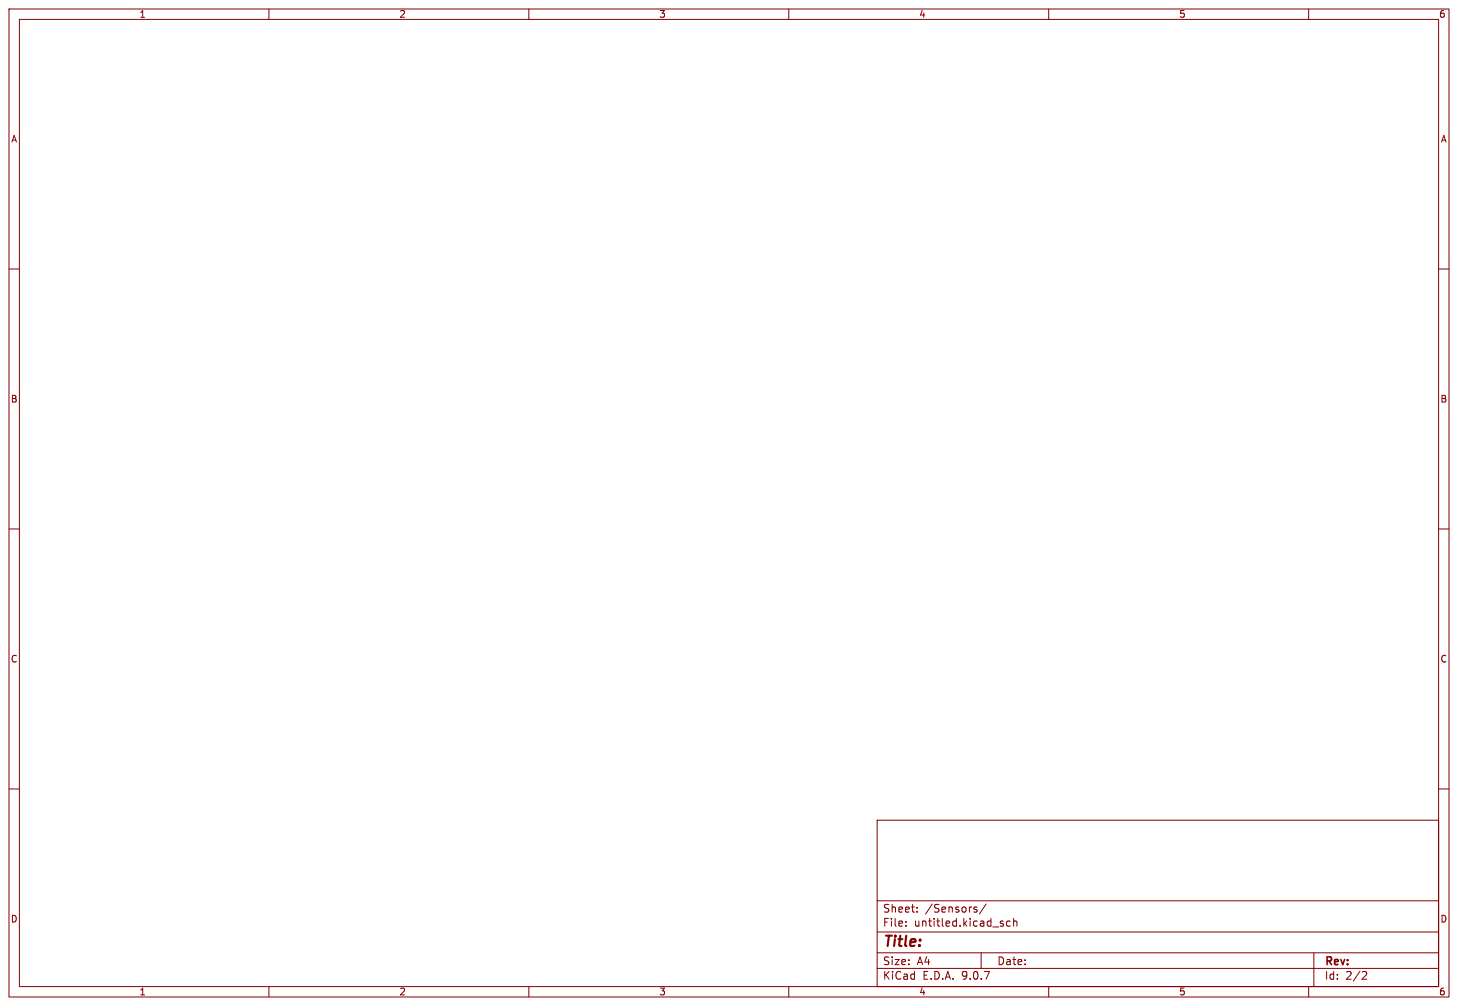
[picture p31: page 2]

Id: 2/2 Title: File: untitled.kicad_sch Sheet: /Sensors/
