jthyn1/underwater_multi-medium_modem_system/Hardware/ED Package (Electrical)/Misc Hardware/KnifeBot_Unit#1Draft#2.pdf

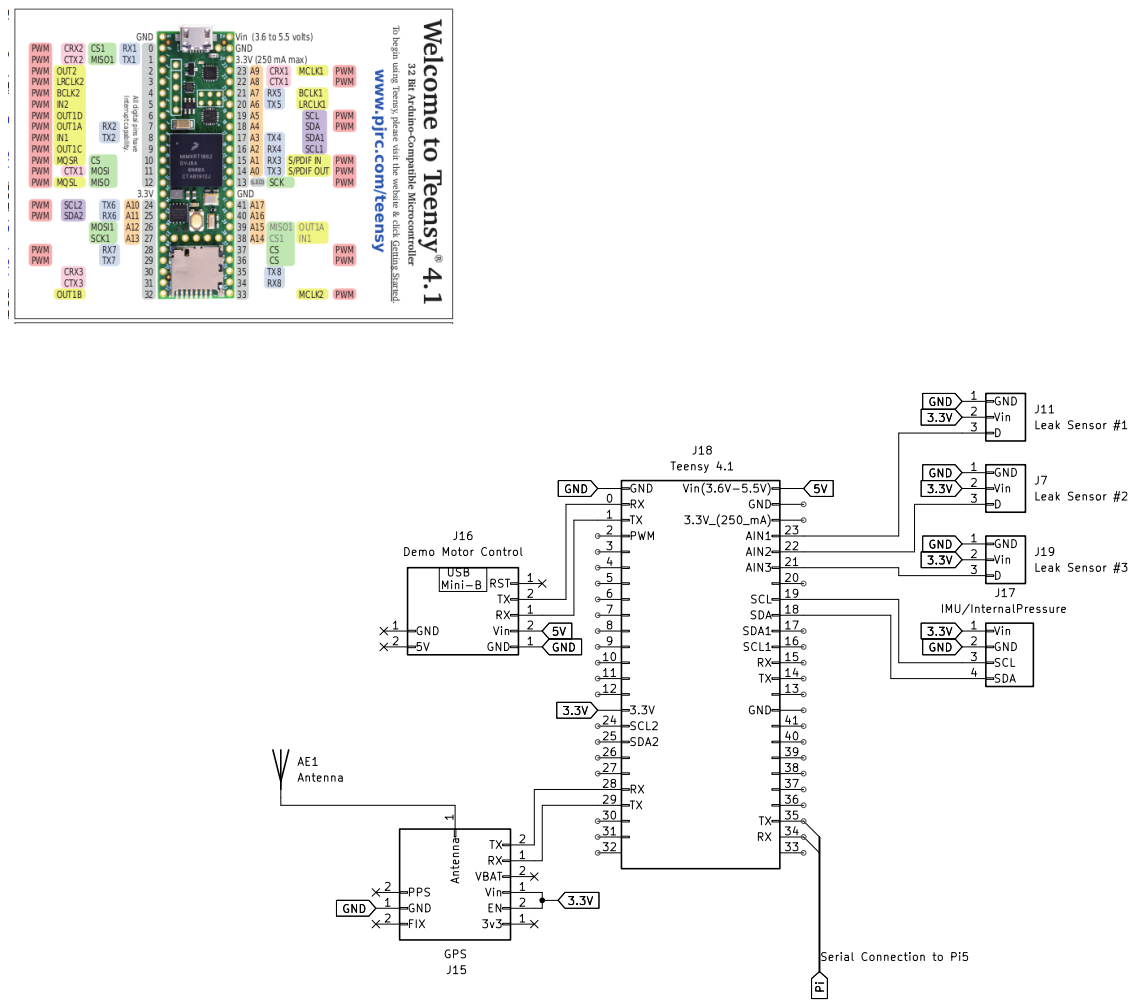
[picture p32: page 1]

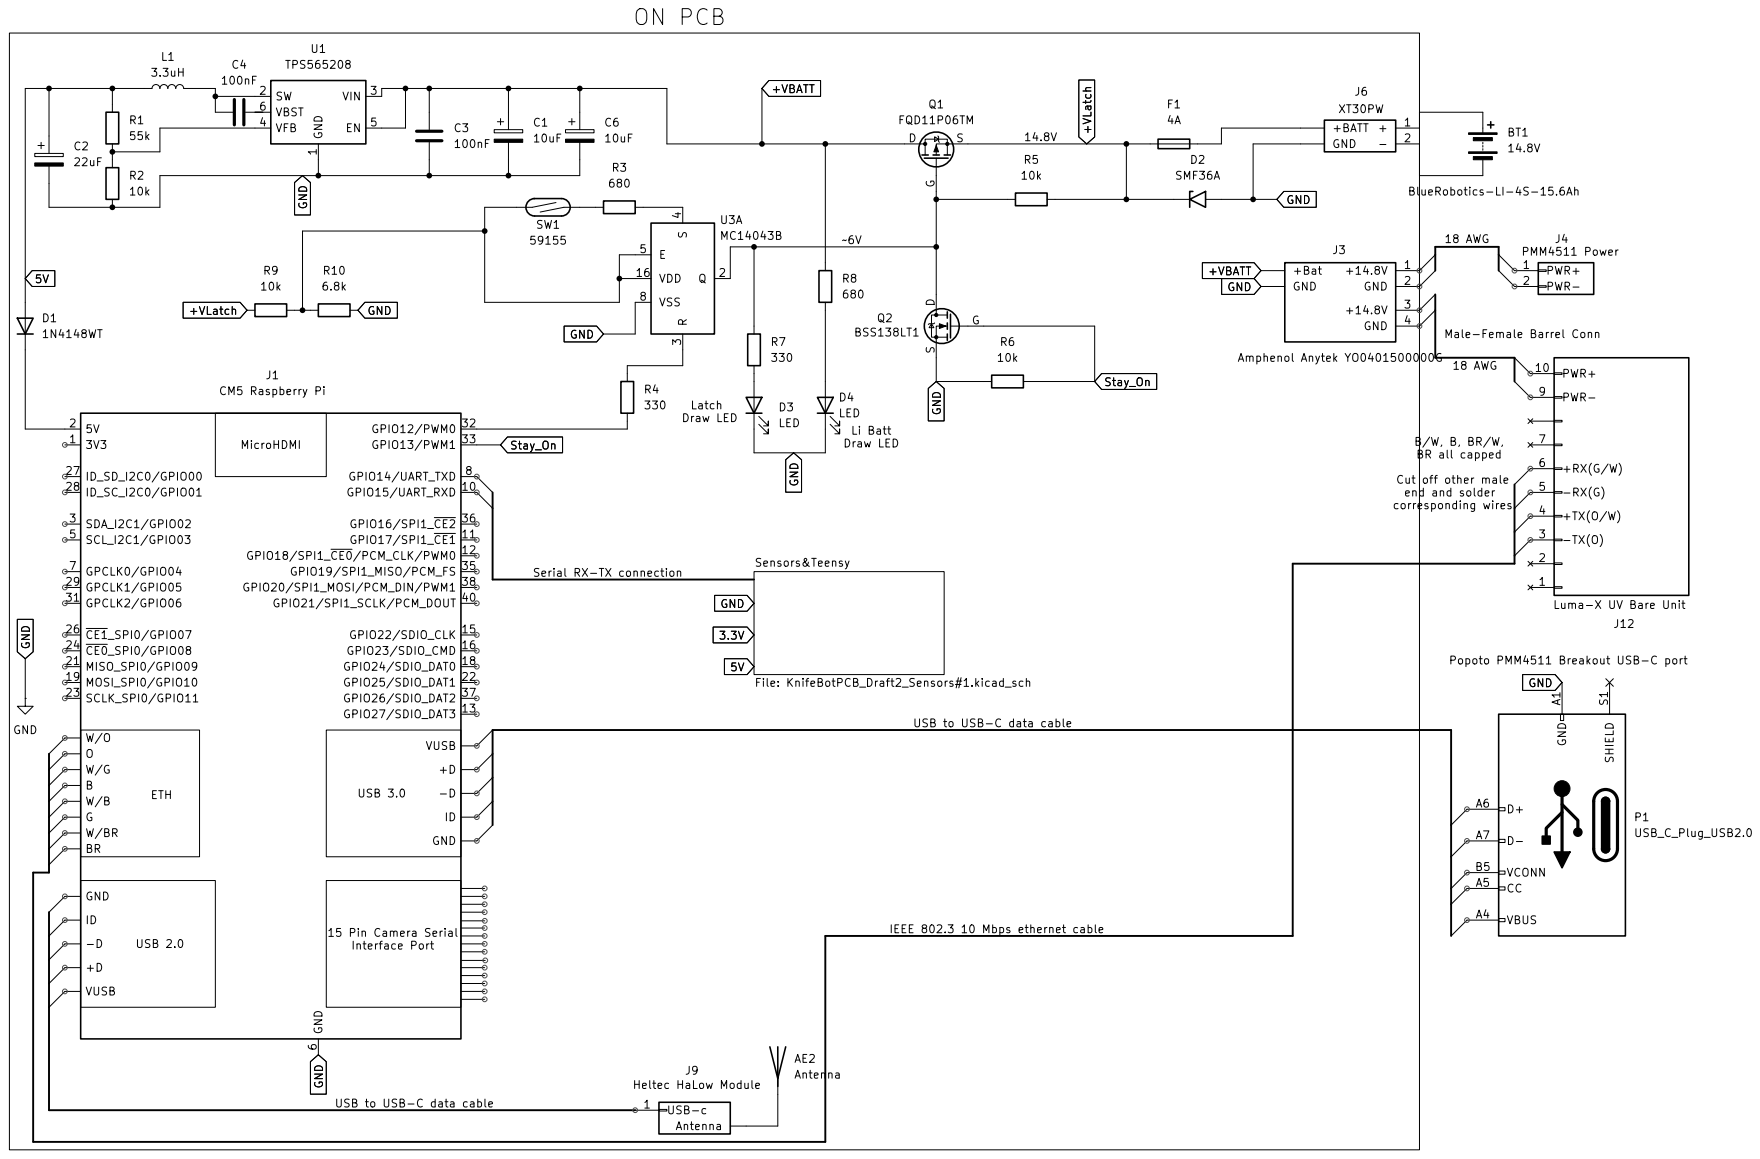
[picture p33: page 2]
