jthyn1/underwater_multi-medium_modem_system/Hardware/ED Package (Electrical)/Misc Hardware/KnifeBot_Unit#2Draft#2.pdf

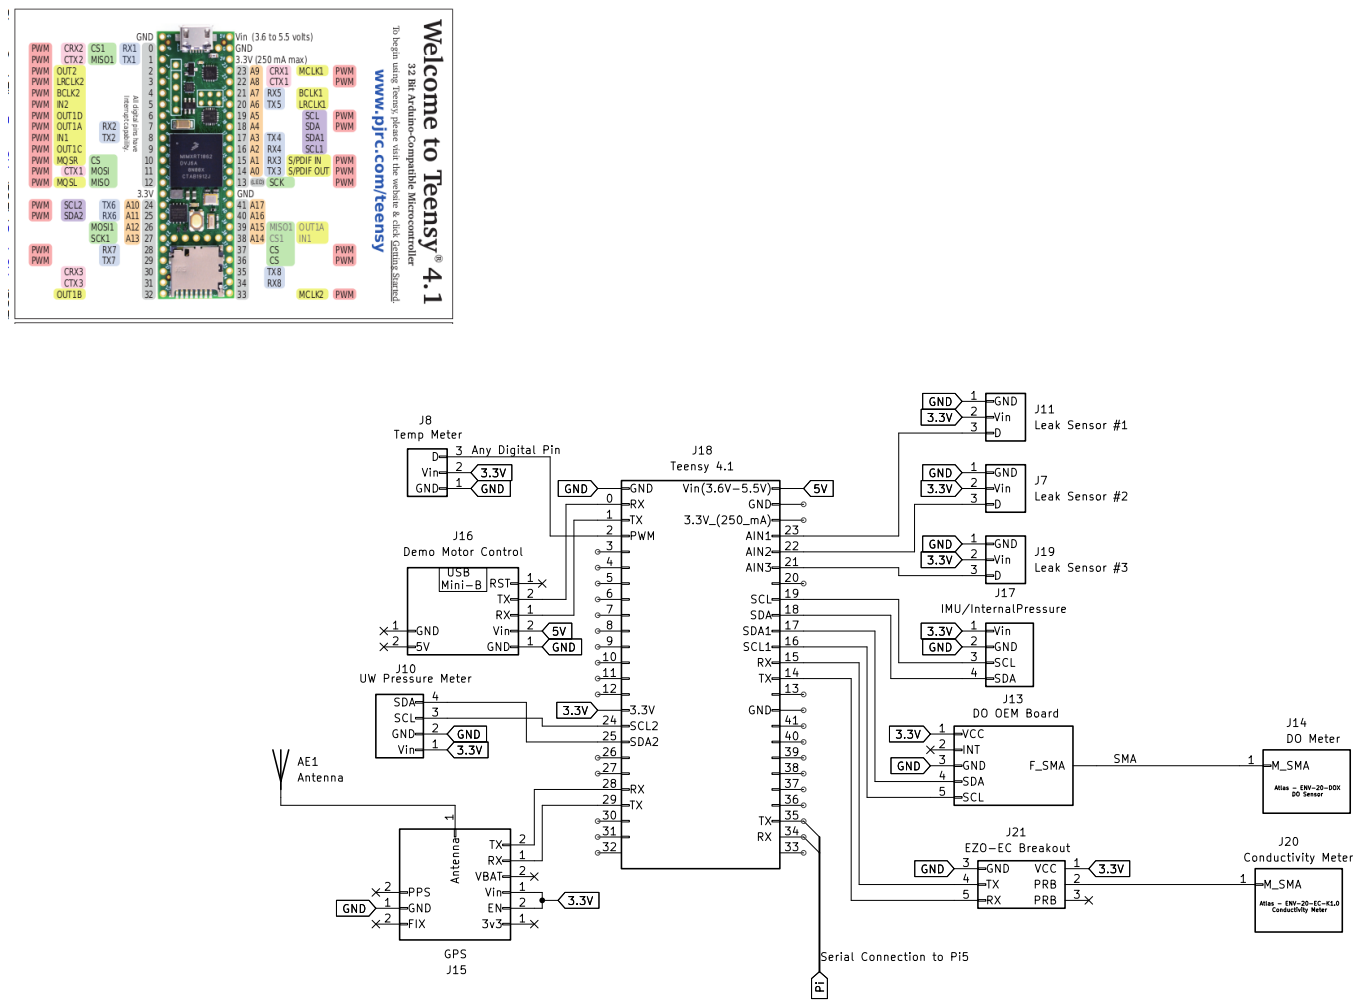
[picture p34: page 1]

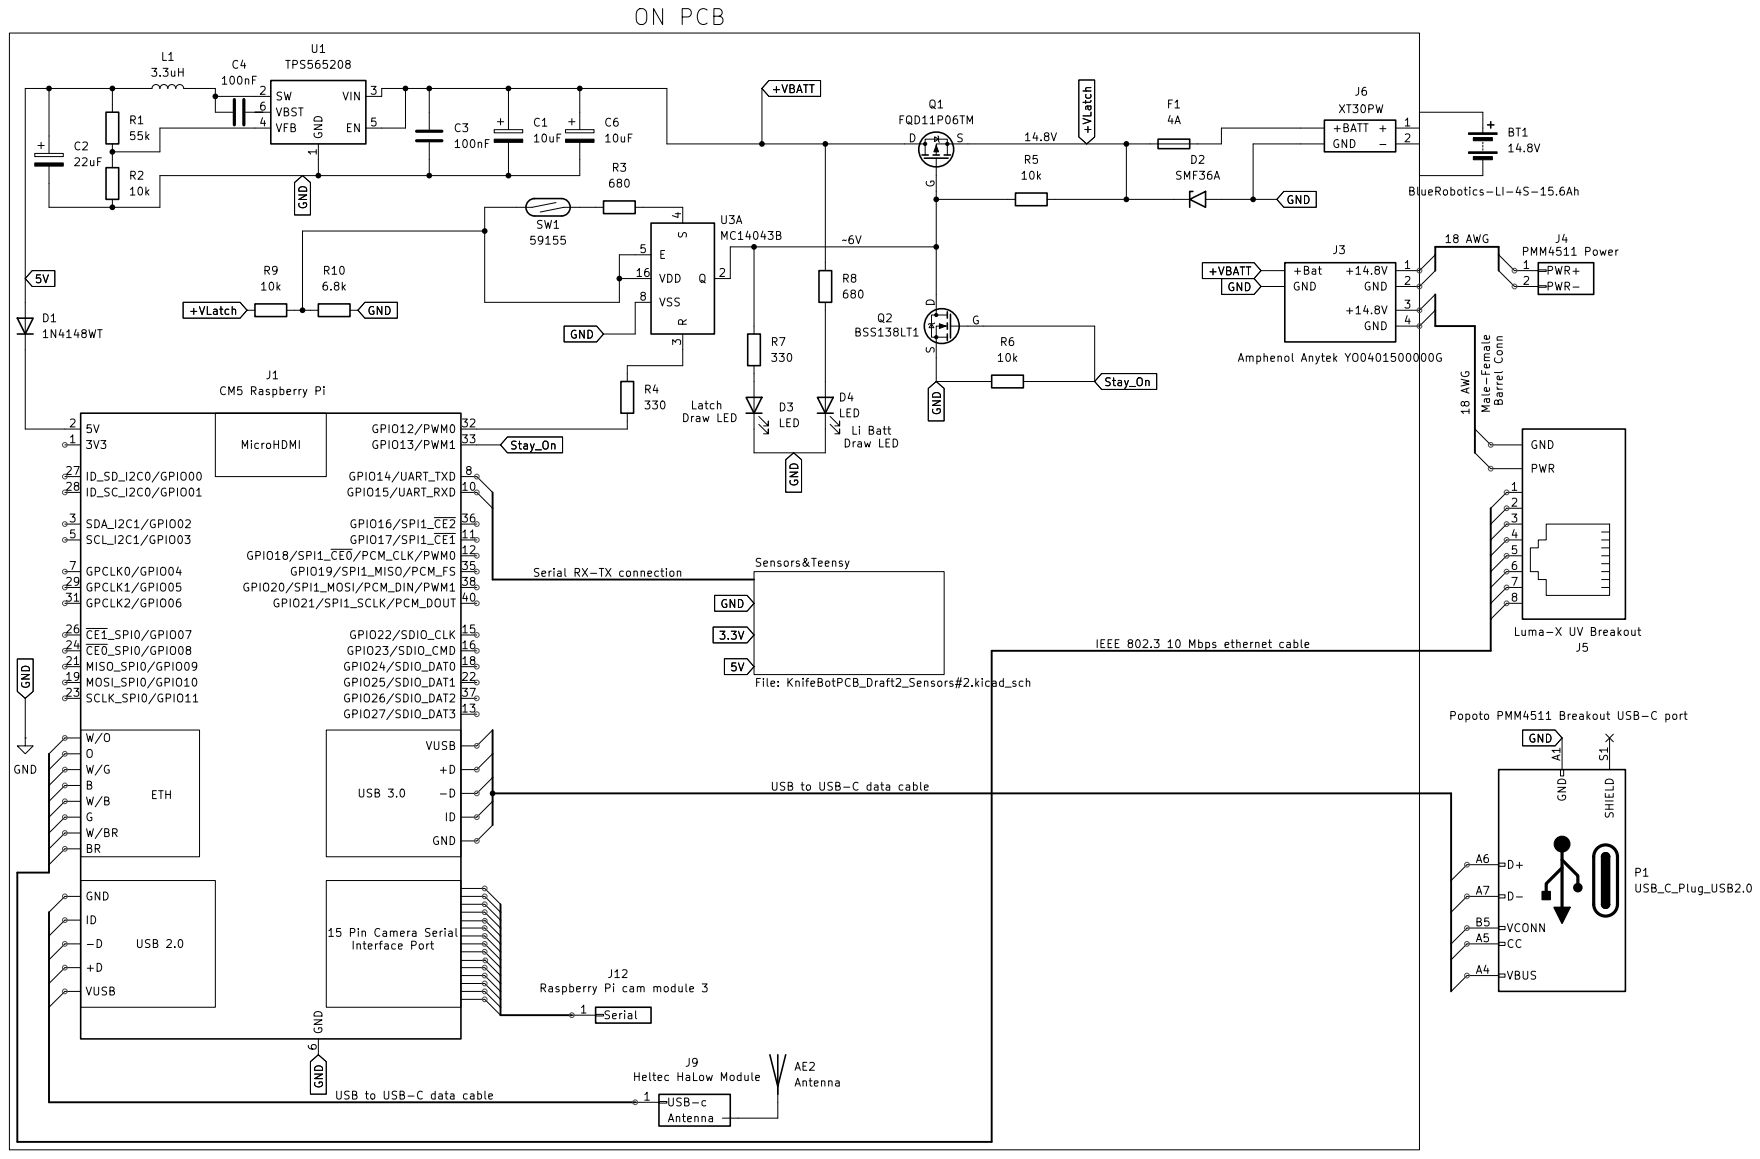
[picture p35: page 2]
