jthyn1/underwater_multi-medium_modem_system/Hardware/ED Package (Electrical)/Misc Hardware/Wiring Diagrams/Knifebot III Block Diagram V2.pdf

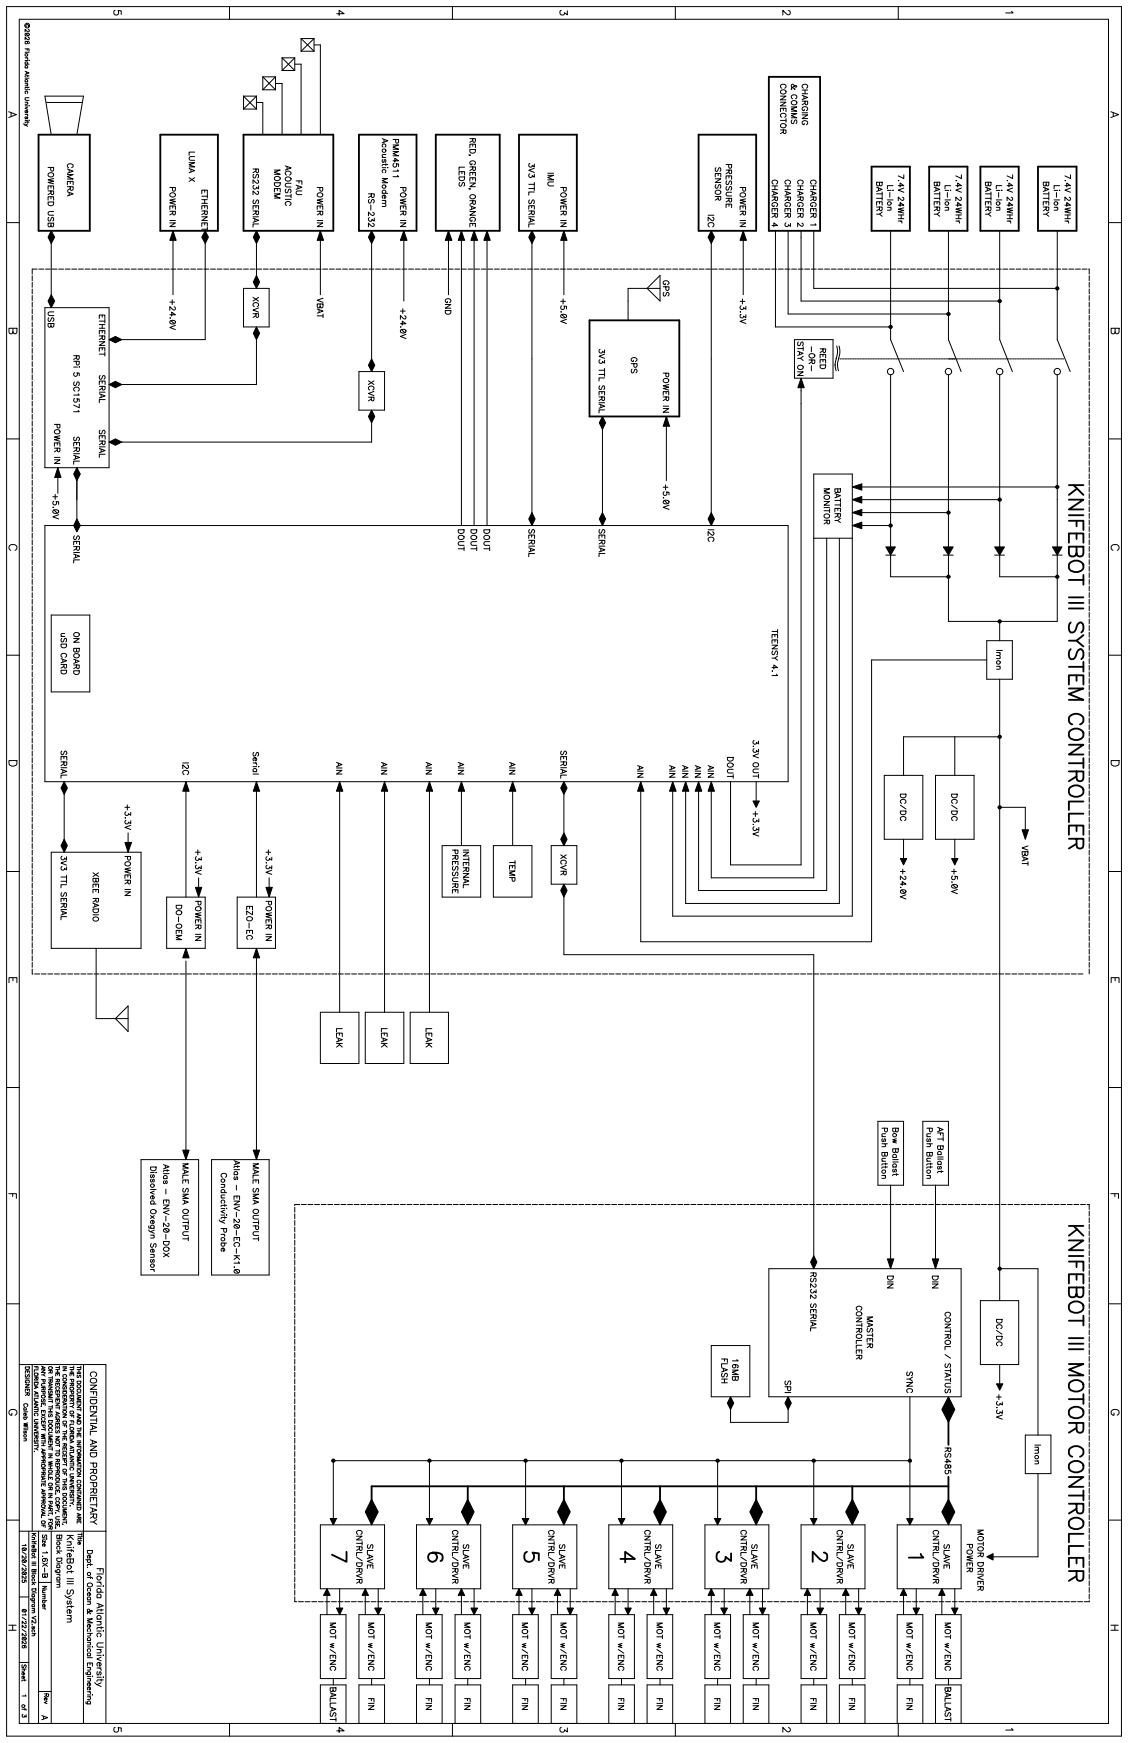
[picture p36: page 1]
