jthyn1/underwater_multi-medium_modem_system/Hardware/ED Package (Electrical)/Misc Hardware/Wiring Diagrams/Teensy-Sensor_Connections.pdf

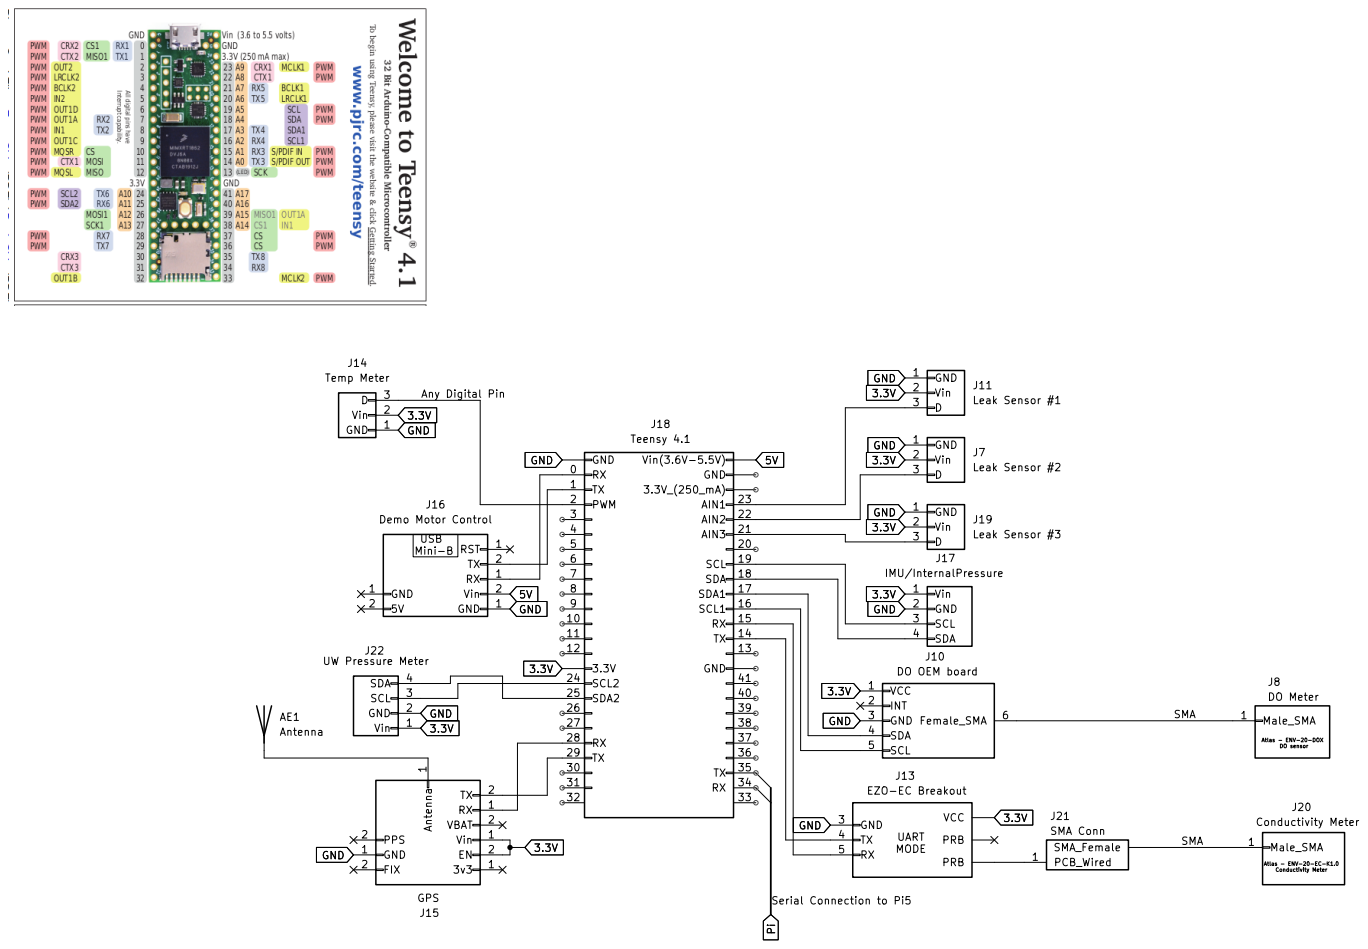
[picture p37: page 1]
