jthyn1/underwater_multi-medium_modem_system/Hardware/ED Package (Electrical)/KiCad File Drafts/KnifeBotPCB_Draft2/KnifeBotPCB_Draft2_Sensors#2.kicad_sch

## KiCad design Hardware/ED Package (Electrical)/KiCad File Drafts/KnifeBotPCB_Draft2/KnifeBotPCB_Draft2_Sensors#2.kicad_sch (2026-07-20)

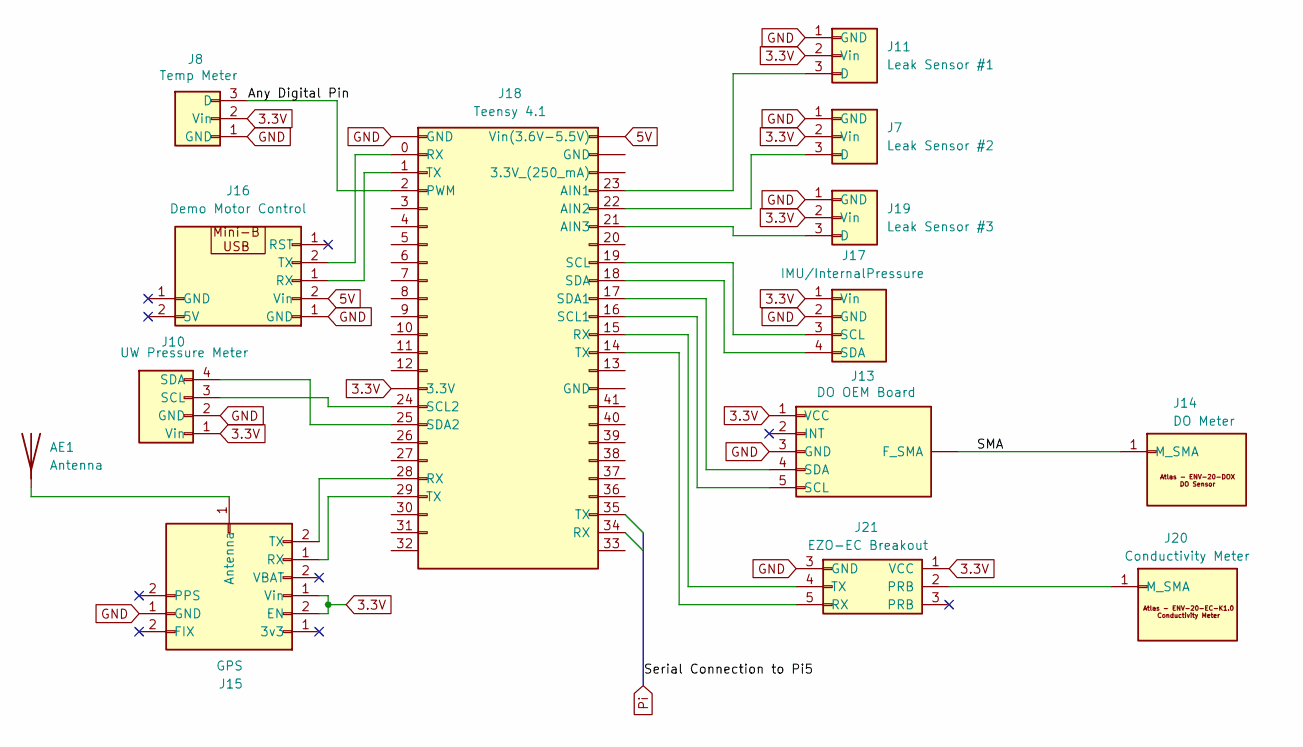
[picture p39: schematic KnifeBotPCB_Draft2_Sensors#2.kicad_sch]

Parts:
AE1: Antenna
J7: Leak Sensor #2
J8: Temp Meter
J10: UW Pressure Meter
J11: Leak Sensor #1
J13: DO OEM Board
J14: DO Meter
J15: GPS
J16: Demo Motor Control
J17: IMU/InternalPressure
J18: Teensy 4.1
J19: Leak Sensor #3
J20: Conductivity Meter
J21: EZO-EC Breakout

Connections:
3.3V: J7.2 (Vin), J8.2 (Vin), J10.1 (Vin), J11.2 (Vin), J13.1 (VCC), J15.1 (3v3), J15.2 (EN), J17.1 (Vin), J18. (GND), J19.2 (Vin), J21.1 (VCC)
5V: J16.2 (Vin), J18. (GND)
Any Digital Pin: J8.3 (D), J18.2 (PWM)
GND: J7.1 (GND), J8.1 (GND), J10.2 (GND), J11.1 (GND), J13.3 (GND), J15.1 (3v3), J16.1 (GND), J17.2 (GND), J18. (GND), J19.1 (GND), J21.3 (GND)
unnamed: AE1.1, J15.1 (3v3)
unnamed: J10.3 (SCL), J18.24 (SCL2)
unnamed: J10.4 (SDA), J18.25 (SDA2)
unnamed: J11.3 (D), J18.23 (AIN1)
unnamed: J13.4 (SDA), J18.17 (SDA1)
unnamed: J13.5 (SCL), J18.16 (SCL1)
unnamed: J15.1 (3v3), J18.29 (TX)
unnamed: J15.2 (EN), J18.28 (RX)
unnamed: J16.1 (GND), J18.1 (TX)
unnamed: J16.2 (Vin), J18.0 (RX)
unnamed: J17.3 (SCL), J18.19 (SCL)
unnamed: J17.4 (SDA), J18.18 (SDA)
unnamed: J18.14 (TX), J21.5 (RX)
unnamed: J18.15 (RX), J21.4 (TX)
unnamed: J18.21 (AIN3), J19.3 (D)
unnamed: J7.3 (D), J18.22 (AIN2)
unnamed: J20.1, J21.2 (PRB)
SMA: J13. (F_SMA), J14.1
