jthyn1/underwater_multi-medium_modem_system/Hardware/ED Package (Electrical)/KiCad File Drafts/KnifeBotPCB_Draft2/KnifeBotPCB_Draft2_Unit#1.kicad_sch

## KiCad design Hardware/ED Package (Electrical)/KiCad File Drafts/KnifeBotPCB_Draft2/KnifeBotPCB_Draft2_Unit#1.kicad_sch (2026-07-20)

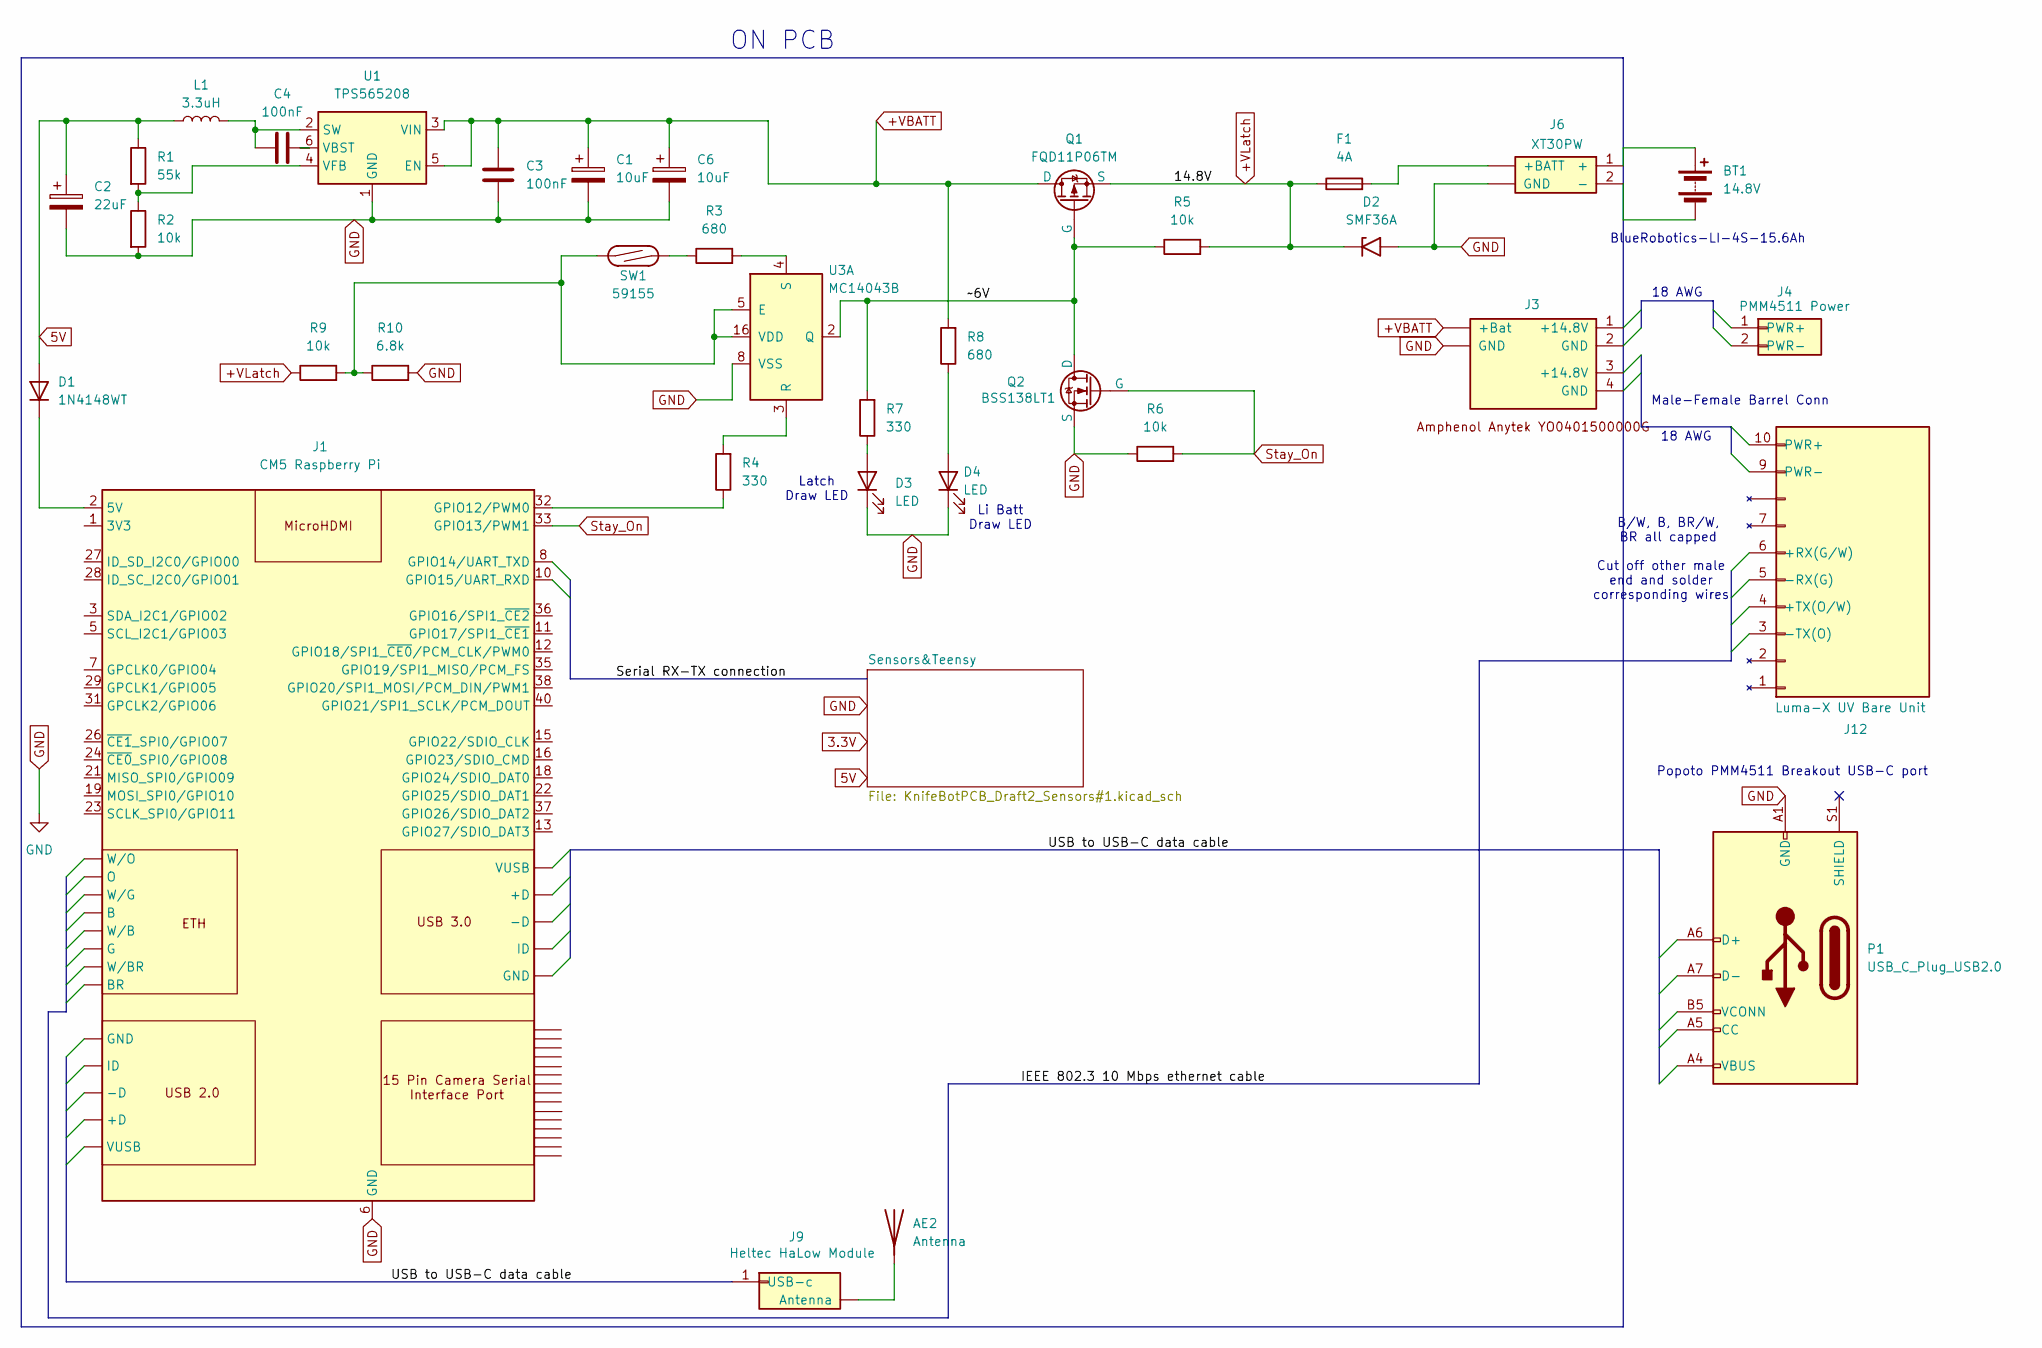
[picture p40: schematic KnifeBotPCB_Draft2_Unit#1.kicad_sch]

Parts:
AE2: Antenna
BT1: 14.8V
C1, C6: 10uF
C2: 22uF
C3, C4: 100nF
D1: 1N4148WT; D_SOD-523
D2: SMF36A; D_SMF
D3, D4: LED
F1: 4A
J1: CM5 Raspberry Pi
J3: (no value)
J4: PMM4511 Power
J6: XT30PW
J9: Heltec HaLow Module
J12: Luma-X UV Bare Unit
L1: 3.3uH
P1: USB_C_Plug_USB2.0
Q1: FQD11P06TM
Q2: BSS138LT1
R1: 55k
R2, R5, R6, R9: 10k
R3, R8: 680
R4, R7: 330
R10: 6.8k
SW1: 59155
U1: TPS565208; SOT-23-6
U3: MC14043B

Connections:
5V: C2.1, D1.2 (A), L1.1, R1.1
+VBATT: C1.1, C3.1, C6.1, J3. (+Bat), Q1.1 (D), R8.2, U1.3 (VIN), U1.5 (EN)
+VLatch: D2.1 (A1), F1.1, Q1.3 (S), R5.2, R9.1
GND: C1.2, C2.2, C3.2, C6.2, D2.2 (A2), D3.1 (K), D4.1 (K), J1.6 (GND), J3. (+Bat), J6. (+BATT), P1.A1 (GND), P1.A12 (GND), P1.B1 (GND), P1.B12 (GND), Q2.3 (S), R2.2, R6.1, R10.2, U1.1 (GND), U3.8 (VSS)
unnamed: AE2.1, J9. (Antenna)
unnamed: BT1.1 (+), J6.1 (+)
unnamed: BT1.2 (-), J6.2 (-)
unnamed: C4.1, L1.2, U1.2 (SW)
unnamed: C4.2, U1.6 (VBST)
unnamed: D1.1 (K), J1.2 (5V), J1.4 (5V)
unnamed: D3.2 (A), R7.1
unnamed: D4.2 (A), R8.1
unnamed: F1.2, J6. (+BATT)
unnamed: J1.1 (3V3), J1.17 (3V3)
unnamed: J1.9 (GND), J1.14 (GND), J1.20 (GND), J1.25 (GND), J1.30 (GND), J1.34 (GND), J1.39 (GND)
unnamed: J1.32 (GPIO12/PWM0), R4.1
unnamed: P1.A4 (VBUS), P1.A9 (VBUS), P1.B4 (VBUS), P1.B9 (VBUS)
unnamed: R1.2, R2.1, U1.4 (VFB)
unnamed: R3.1, SW1.1
unnamed: R3.2, U3.4 (S)
unnamed: R4.2, U3.3 (R)
unnamed: R9.2, R10.1, SW1.2, U3.5 (E), U3.16 (VDD)
Stay_On: J1.33 (GPIO13/PWM1), Q2.2 (G), R6.2
~6V: Q1.2 (G), Q2.1 (D), R5.1, R7.2, U3.2 (Q)

Notes on the sheet:
B/W, B, BR/W, BR all capped
BlueRobotics-LI-4S-15.6Ah
18 AWG
ON PCB
Popoto PMM4511 Breakout USB-C port
Li Batt Draw LED
Latch Draw LED
Male-Female Barrel Conn
Cut off other male end and solder corresponding wires
