jthyn1/underwater_multi-medium_modem_system/Hardware/ED Package (Electrical)/KiCad File Drafts/KnifeBotPCB_Draft3/KnifeBotPCB_Draft3_Unit#1_WD .kicad_sch

## KiCad design Hardware/ED Package (Electrical)/KiCad File Drafts/KnifeBotPCB_Draft3/KnifeBotPCB_Draft3_Unit#1_WD .kicad_sch (2026-07-20)

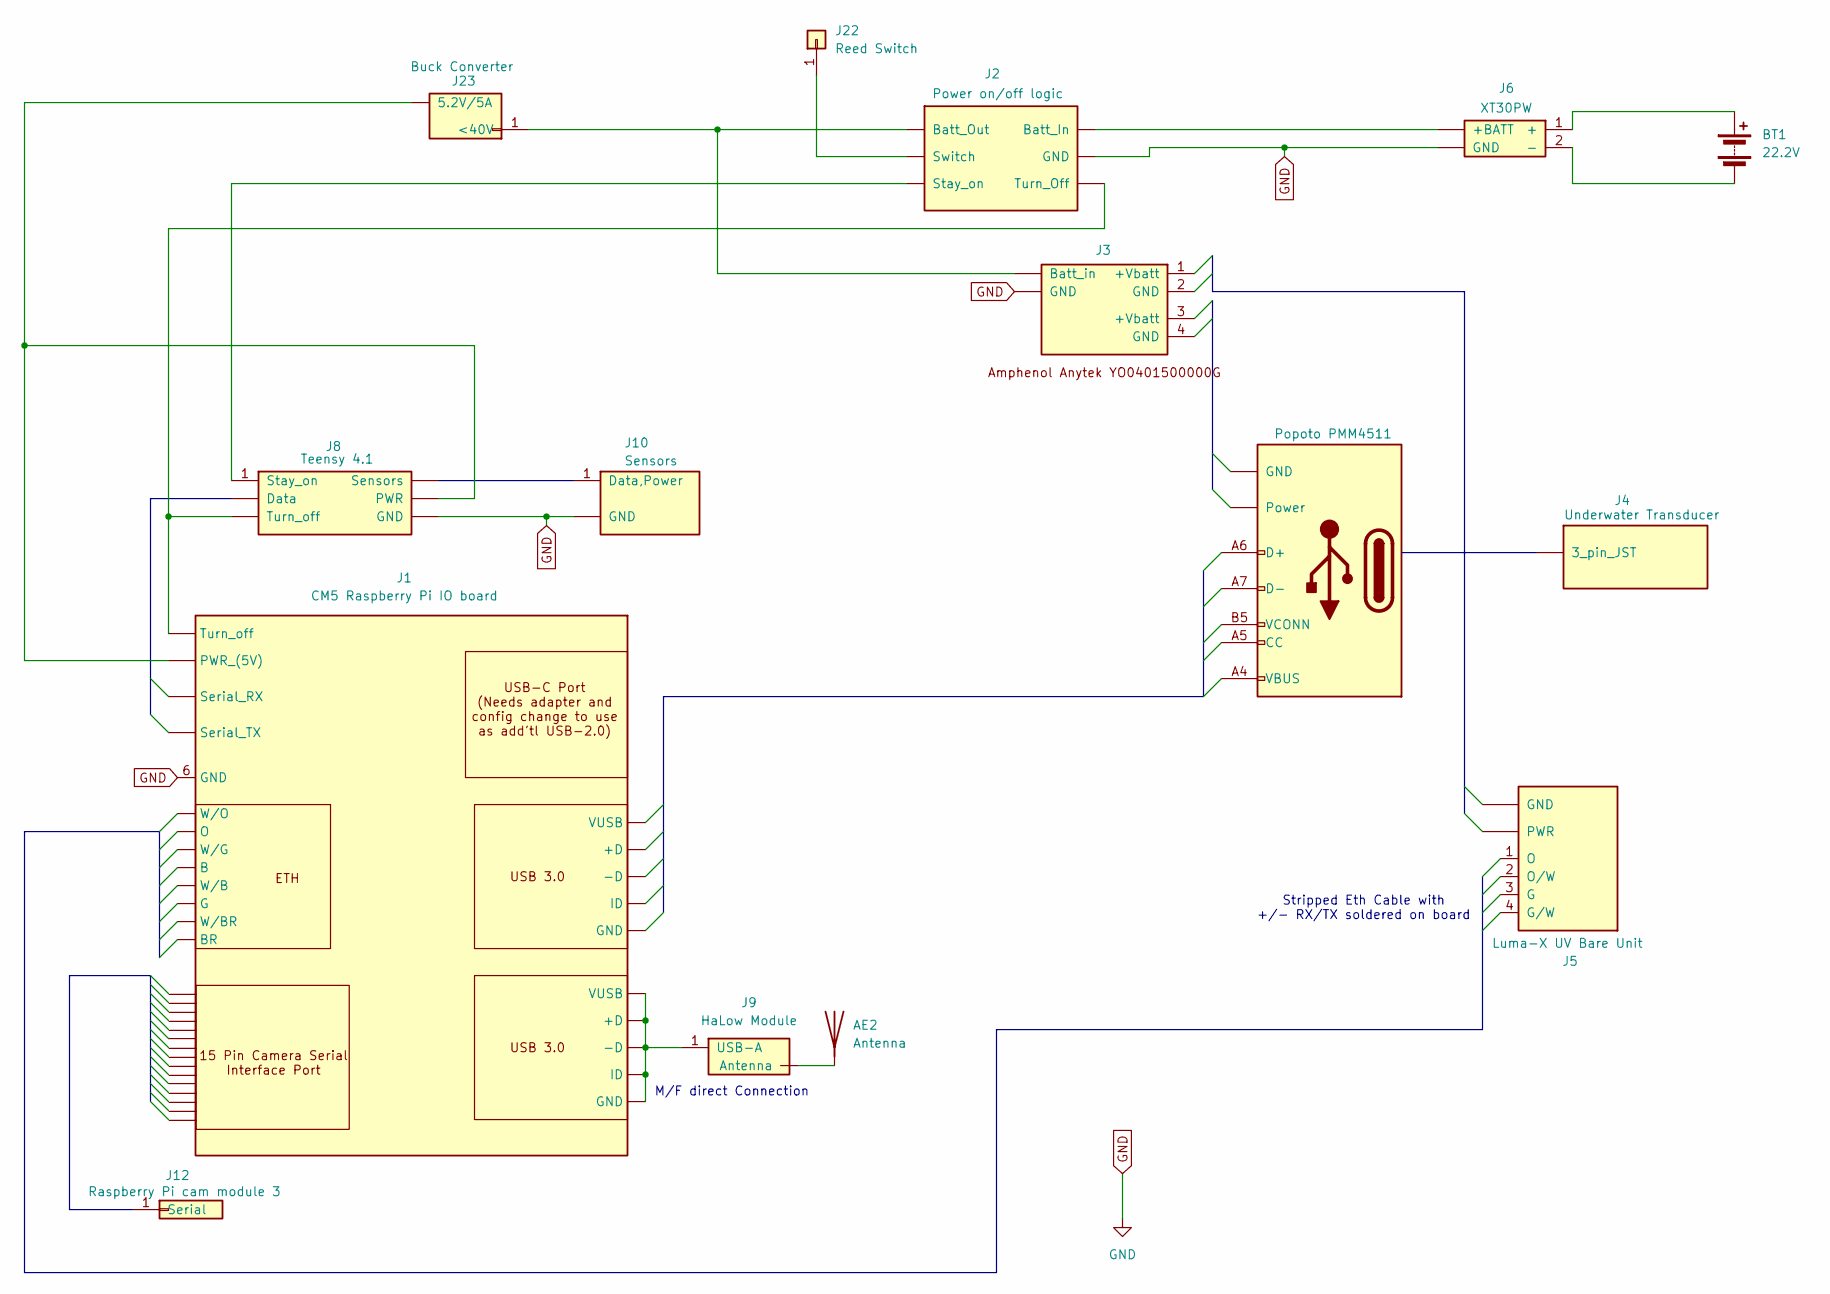
[picture p41: schematic KnifeBotPCB_Draft3_Unit#1_WD .kicad_sch]

Parts:
AE2: Antenna
BT1: 22.2V
J1: CM5 Raspberry Pi IO board
J2: Power on/off logic
J3: (no value)
J4: Underwater Transducer
J5: Luma-X UV Bare Unit
J6: XT30PW
J8: Teensy 4.1
J9: HaLow Module
J10: Sensors
J12: Raspberry Pi cam module 3
J22: Reed Switch
J23: Buck Converter
P1: Popoto PMM4511

Connections:
GND: J1.6 (GND), J2., J3. (Batt_in), J6. (+BATT), J8. (Data), J10. (GND)
unnamed: AE2.1, J9. (Antenna)
unnamed: BT1.1 (+), J6.1 (+)
unnamed: BT1.2 (-), J6.2 (-)
unnamed: J1.9 (GND), J1.14 (GND), J1.20 (GND), J1.25 (GND), J1.30 (GND), J1.34 (GND), J1.39 (GND)
unnamed: J1. (VUSB), J2., J8. (Data), J9.1 (USB-A), J23. (5.2V/5A)
unnamed: J2., J3. (Batt_in), J6. (+BATT), J8.1 (Stay_on), J22.1, J23.1 (<40V)
unnamed: P1.A4 (VBUS), P1.A9 (VBUS), P1.B4 (VBUS), P1.B9 (VBUS)

Notes on the sheet:
Stripped Eth Cable with +/- RX/TX soldered on board
M/F direct Connection
