jthyn1/underwater_multi-medium_modem_system/Hardware/ED Package (Electrical)/KiCad File Drafts/OpticalPCB/untitled.kicad_sch

## KiCad design Hardware/ED Package (Electrical)/KiCad File Drafts/OpticalPCB/untitled.kicad_sch (2026-07-20)

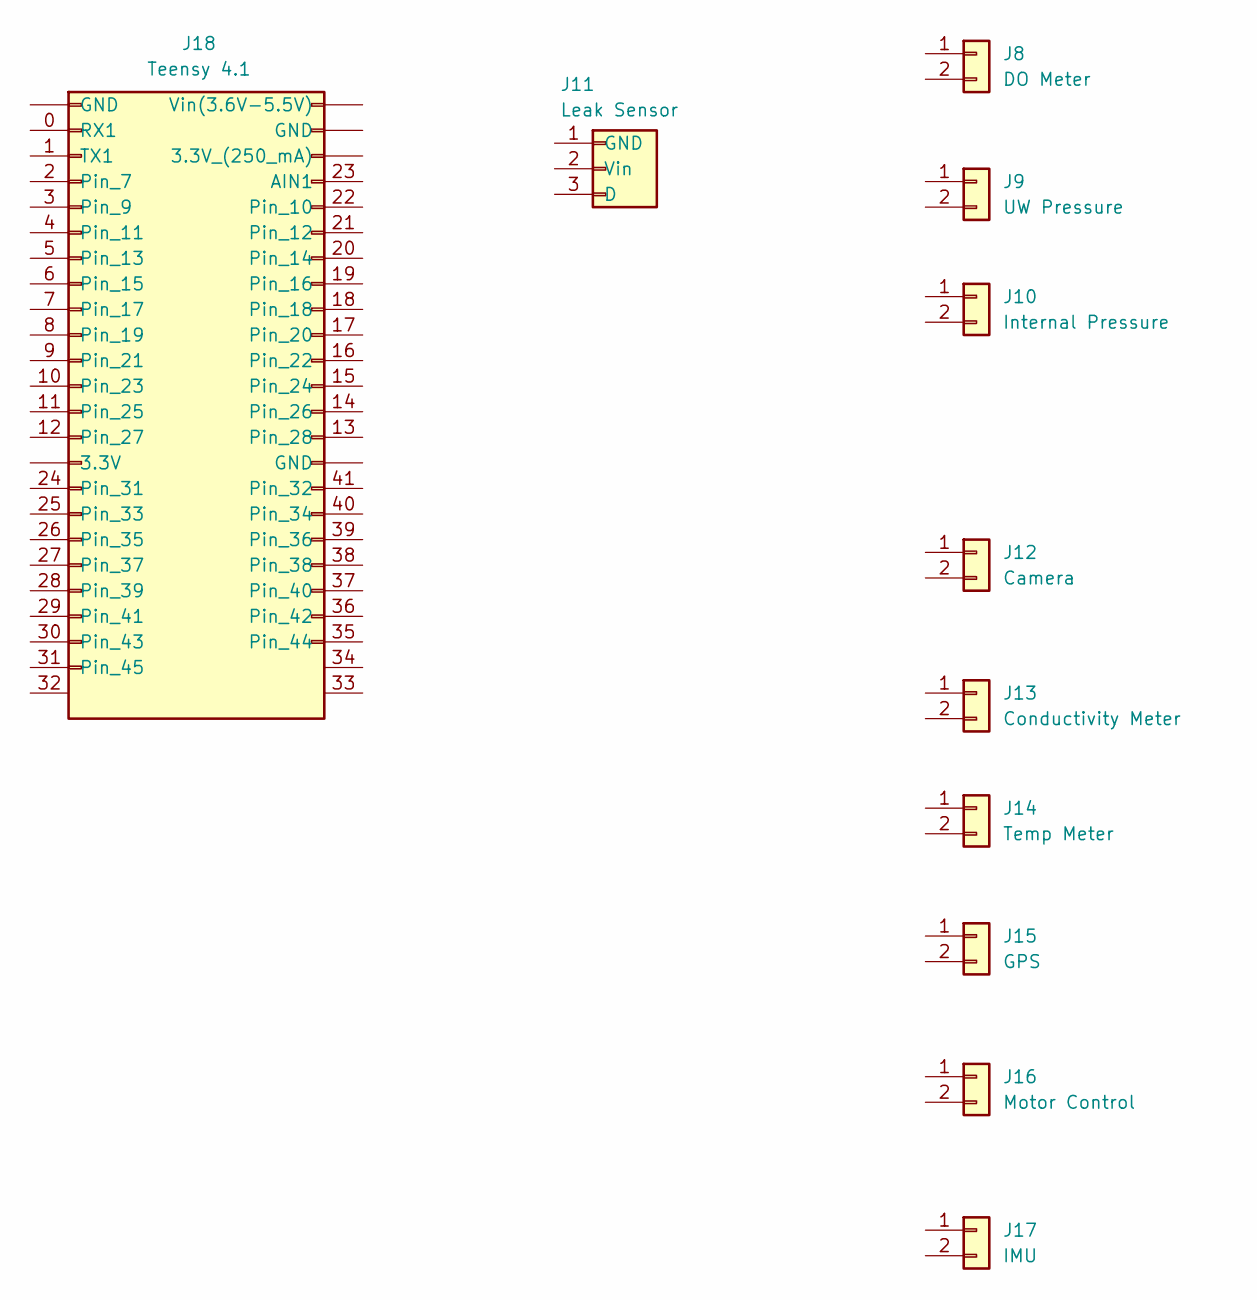
[picture p42: schematic untitled.kicad_sch]

Parts:
J8: DO Meter
J9: UW Pressure
J10: Internal Pressure
J11: Leak Sensor
J12: Camera
J13: Conductivity Meter
J14: Temp Meter
J15: GPS
J16: Motor Control
J17: IMU
J18: Teensy 4.1
