jthyn1/underwater_multi-medium_modem_system/(commit log)

2026-06-15 Hardware/Documentation
    All of the hardware design files and documentation for components
    [BASE_PLATE.STL, CommModules.ods, CommModules.xlsx, ED2_tests - legend_for_Sheet1.csv, KnifeBotPCB_Draft2.kicad_pcb, KnifeBotPCB_Draft2_Sensors#1.kicad_sch, KnifeBotPCB_Draft2_Sensors#2.kicad_sch, KnifeBotPCB_Draft2_Unit#1.kicad_sch]
2026-06-15 Software
    All of the different software files for the project
    [pyvenv.cfg]
2026-07-20 Updating Repo with Current Working Files
2026-07-20 Updated Last Commit with "Old Software"
    [BASE_PLATE.STL, CommModules.xlsx, KnifeBotPCB_Draft2.kicad_pcb, KnifeBotPCB_Draft2_Sensors#1.kicad_sch, KnifeBotPCB_Draft2_Sensors#2.kicad_sch, KnifeBotPCB_Draft2_Unit#1.kicad_sch, KnifeBotPCB_Draft2_Unit#2.kicad_sch, KnifeBotPCB_Draft3_Sensors#1.kicad_sch]
2026-07-20 End of first day; began poller.py development
    [KnifeBotPCB_Draft3_Sensors#2.kicad_sch, KnifeBotPCB_Draft3_Unit#2_SCH.kicad_sch, KnifeBotPCB_Draft4_Unit#2_SCH.kicad_pcb, KnifeBotPCB_Draft4_Unit#2_SCH.kicad_sch, KnifeBotPCB_Draft5_Sensors#2.kicad_sch, KnifeBotPCB_Draft5_Unit#2_SCH.kicad_pcb, KnifeBotPCB_Draft5_Unit#2_SCH.kicad_sch]
2026-07-27 Cleaned up Data processing software naming/finished teensy sensor firmware
    [Power_Componet_Spreadsheet.xlsx]
2026-07-27 Fix oldSoftware: track as regular directory instead of stale gitlink
    [pyvenv.cfg]
